KAJPER/WETI/dokumentacja-etap2/WETI_Kacper_Popko_Etap2.tex

\documentclass[a4paper,11pt]{article}

% ════════════════════ Kodowanie i język ════════════════════
\usepackage[T1]{fontenc}
\usepackage[utf8]{inputenc}
\usepackage{lmodern}
\usepackage[polish]{babel}

% ════════════════════ Marginesy ════════════════════
\usepackage[margin=2.5cm]{geometry}

% ════════════════════ Matematyka ════════════════════
\usepackage{amsmath}
\usepackage{amssymb}
\usepackage{siunitx}
\sisetup{
	output-decimal-marker = {,},
	per-mode = symbol,
	range-phrase = { -- },
}
\DeclareSIUnit{\baud}{Bd}
\DeclareSIUnit{\pkt}{pkt}
\DeclareSIUnit{\PLN}{PLN}

% ════════════════════ Grafika i tabele ════════════════════
\usepackage{graphicx}
\usepackage{float}
\usepackage{booktabs}
\usepackage{array}
\usepackage{tabularx}
\usepackage{longtable}
\usepackage{caption}
\usepackage{pgfplots}
\pgfplotsset{compat=1.16}

% ════════════════════ Kolory i linki ════════════════════
\usepackage[dvipsnames]{xcolor}
\usepackage{hyperref}
\hypersetup{
	colorlinks=true,
	linkcolor=NavyBlue,
	citecolor=NavyBlue,
	urlcolor=RoyalBlue,
}

% ════════════════════ Listingi kodu ════════════════════
\usepackage{listings}
\lstset{
	language=C,
	basicstyle=\ttfamily\footnotesize,
	keywordstyle=\color{NavyBlue}\bfseries,
	commentstyle=\color{Gray}\itshape,
	stringstyle=\color{OliveGreen},
	numbers=left,
	numberstyle=\tiny\color{Gray},
	frame=single,
	breaklines=true,
	captionpos=b,
	tabsize=4,
	showstringspaces=false,
}

% ════════════════════ Nagłówek / stopka ════════════════════
\usepackage{fancyhdr}
\pagestyle{fancy}
\fancyhf{}
\fancyhead[L]{\small Bezkontaktowy miernik odległości --- Etap 2 (prototyp)}
\fancyhead[R]{\small Wygraj Indeks WETI 2026}
\fancyfoot[C]{\thepage}
\renewcommand{\headrulewidth}{0.4pt}

\usepackage{setspace}
\onehalfspacing
\usepackage{parskip}
\usepackage{enumitem}

% ══════════════════════════════════════════════════════════════
\begin{document}

% ════════════════════ STRONA TYTUŁOWA ════════════════════
\begin{titlepage}
	\centering
	\vspace*{1.5cm}

	{\Large Ogólnopolski Konkurs Projektowy}\\[0.3cm]
	{\Large\textbf{,,Wygraj Indeks WETI'' --- edycja 2026}}\\[0.2cm]
	{\large Wydział Elektroniki, Telekomunikacji i~Informatyki\\
		Politechnika Gdańska}

	\vspace{1.5cm}

	{\Huge\bfseries Bezkontaktowy miernik odległości}\\[0.5cm]
	{\Large Metoda hybrydowa Pulse-Phase Ranging\\z~kompensacją temperatury}\\[0.4cm]
	{\Large \textbf{Etap 2 --- dokumentacja prototypu}}\\[0.3cm]
	{\large Realizacja toru zgrubnego (Time-of-Flight) ze~sprzętową,\\
		bezlatencyjną detekcją echa}

	\vspace{2.0cm}

	{\large
		\begin{tabular}{rl}
			\textbf{Autor:}    & Kacper Popko \\
			\textbf{Opiekun:}  & Mateusz Karanowski \\
			\textbf{Szkoła:}   & II Liceum Ogólnokształcące im.\ ks.\ Anny z~Sapiehów \\
			                   & Jabłonowskiej w~Białymstoku \\
			\textbf{E-mail:}   & kacper@kajpa.pl \\
			\textbf{Data:}     & Czerwiec 2026 \\
		\end{tabular}
	}

	\vspace{1.5cm}

	\begin{tabular}{ll}
		\toprule
		\textbf{Mikrokontroler} & ATtiny1616-SN (tinyAVR 1-series) \\
		\textbf{Metoda} & Pulse-Phase Ranging \SI{40}{\kilo\hertz}: ToF (obwiednia ADC) + faza (Goertzel) \\
		\textbf{Zakres} & \SIrange{10}{50}{\centi\metre} \\
		\textbf{Toolchain} & AVR-GCC 15.2 + avrdude 8.1 (czysto rejestrowo) \\
		\bottomrule
	\end{tabular}

	\vfill
\end{titlepage}

\tableofcontents
\newpage

% ══════════════════════════════════════════════════════════════
\section{Wprowadzenie i~zakres Etapu 2}
\label{sec:wstep}

Niniejszy dokument stanowi dokumentację \textbf{zbudowanego i~uruchomionego
prototypu} bezkontaktowego miernika odległości, dostarczanego w~ramach Etapu~2
konkursu ,,Wygraj Indeks WETI 2026''. W~odróżnieniu od dokumentacji Etapu~1
(projekt koncepcyjny) opisuje on \emph{rzeczywisty stan urządzenia} po montażu,
uruchomieniu i~strojeniu na stanowisku pomiarowym.

Projekt kontynuuje przyjętą w~Etapie~1 \textbf{metodę hybrydową Pulse-Phase
Ranging z~kompensacją temperatury}. Metoda ta składa się z~dwóch etapów: pomiaru
\emph{zgrubnego} czasu przelotu (Time-of-Flight), który eliminuje
niejednoznaczność, oraz pomiaru \emph{dokładnego} fazy echa (algorytm
Goertzela), dającego rozdzielczość sub-milimetrową. W~prototypie
\textbf{zaimplementowano i~uruchomiono oba etapy}: pomiar ToF przez
próbkowanie obwiedni echa przetwornikiem ADC oraz wyznaczanie fazy nośnej
\SI{40}{\kilo\hertz} algorytmem Goertzela, a~także pełną kompensację
temperatury. Zapewnia to poprawny pomiar w~całym zakresie
\SIrange{10}{50}{\centi\metre} (sek.~\ref{sec:firmware}--\ref{sec:wyniki}).
Dodatkowo zweryfikowano sprzętową, bezlatencyjną ścieżkę detekcji progowej
\texttt{AC1+DAC1+EVSYS+TCB0} (sek.~\ref{sec:hw_capture}).

W~trakcie realizacji prototypu wprowadzono szereg zmian względem założeń
projektowych --- wynikających z~praktycznej weryfikacji sprzętu oraz z~analizy
dokumentacji mikrokontrolera. Zmiany te zestawiono w~sekcji~\ref{sec:zmiany}.
Najistotniejsza dotyczy ścieżki detekcji echa: pierwotnie zakładano użycie
komparatora \texttt{AC0}, jednak weryfikacja Tabeli~5-1 noty katalogowej
wykazała, że wejście echa (pin \texttt{PB4}) jest dodatnim wejściem
\texttt{AINP3} komparatora \texttt{AC1}, a~nie \texttt{AC0}. Skorygowano to
w~firmware, dzięki czemu sprzętowa, bezlatencyjna detekcja czasu przelotu
działa poprawnie.

\subsection{Spełnienie wymagań konkursowych}

\begin{table}[H]
	\centering
	\caption{Status wymagań konkursowych w~prototypie}
	\label{tab:wymagania}
	\begin{tabularx}{\textwidth}{llX}
		\toprule
		\textbf{Parametr} & \textbf{Wymóg} & \textbf{Stan w~prototypie} \\
		\midrule
		Napięcie zasilania & \SI{5}{\volt} & Spełnione; LDO MCP1700 $\to$ \SI{3,3}{\volt} \\
		Zakres pomiaru & \SIrange{10}{50}{\centi\metre} & Spełnione; potwierdzone pomiarami \\
		Wykrywany obiekt & Karton $20\times20$~\si{\centi\metre} & Spełnione \\
		Błąd RMSE & im mniejszy tym lepiej & \textbf{zmierzony $\approx\SI{2,4}{\milli\metre}$} (sek.~\ref{sec:wyniki}) \\
		Pobór mocy & $100/P_{[\si{\milli\watt}]}$ & zmierzone: spocz.\ \SI{0,9}{\milli\watt} $\to$ 50~pkt (sek.~\ref{sec:moc}) \\
		Koszt elementów & $2500/C_{[\text{PLN}]}$ & \SI{43,73}{\PLN} $\to$ 50~pkt (bez~zmian) \\
		\bottomrule
	\end{tabularx}
\end{table}

% ══════════════════════════════════════════════════════════════
\section{Architektura zbudowanego urządzenia}
\label{sec:arch}

\subsection{Schemat blokowy toru sygnałowego}

Tor pomiarowy realizuje pomiar czasu przelotu (Time-of-Flight) impulsu
ultradźwiękowego \SI{40}{\kilo\hertz}:

\begin{enumerate}[nosep]
	\item Mikrokontroler generuje paczkę (burst) \SI{40}{\kilo\hertz} na pinie
	\texttt{PB0}, wzmacnianą tranzystorem \texttt{BC817} sterującym nadajnik US.
	\item Echo odbierane przez przetwornik RX jest wzmacniane dwustopniowym
	torem na \texttt{MCP6002} (wzmocnienie $\sim$10$\times$, filtr pasmowy wokół
	\SI{40}{\kilo\hertz}).
	\item Wzmocniony sygnał echa (pin \texttt{PB4 = ADC0 AIN9}) jest szybko
	próbkowany przetwornikiem ADC; z~obwiedni wyznaczany jest początek echa
	(czas przelotu), a~z~przebiegu --- faza nośnej (Goertzel).
	\item Niezależnie ten sam sygnał trafia na komparator \texttt{AC1}
	(próg z~\texttt{DAC1}) $\to$ \texttt{EVSYS} $\to$ \texttt{TCB0} ---
	zweryfikowana, sprzętowa, bezlatencyjna ścieżka detekcji progowej.
	\item Temperatura z~termistora NTC koryguje prędkość dźwięku;
	odległość $D = c(T)\cdot t_{ToF}/2$.
\end{enumerate}

\subsection{Mapa pinów ATtiny1616 (stan rzeczywisty)}
\label{sec:pinout}

Tabela~\ref{tab:pinout} przedstawia \textbf{faktyczne} przyporządkowanie pinów
w~zbudowanym prototypie. Różni się ono od wstępnego projektu (Etap~1) ---
zmiany wynikły z~optymalizacji rozprowadzenia ścieżek PCB oraz z~korekty
przypisania komparatora (patrz sek.~\ref{sec:zmiany}).

\begin{table}[H]
	\centering
	\caption{Mapa pinów ATtiny1616 w~prototypie}
	\label{tab:pinout}
	\begin{tabularx}{\textwidth}{llX}
		\toprule
		\textbf{Pin} & \textbf{Funkcja} & \textbf{Opis / peryferiał} \\
		\midrule
		PA0 & UPDI & Programowanie / debug \\
		PA3 & PRZYCISK & Wejście, pull-up, aktywny stan niski (start pomiaru) \\
		PA4 & LED & Wyjście, sygnalizacja pomiaru \\
		PA5 & TERMISTOR & ADC0 AIN5 (kompensacja temperatury, NTC \SI{10}{\kilo\ohm}) \\
		PA6 & GATE Q1 & Sterowanie P-MOSFET BSS84 (zasilanie toru RX) \\
		PB0 & TX BURST & Generacja \SI{40}{\kilo\hertz} (programowa) $\to$ R1 $\to$ BC817 \\
		PB2 & USART0 TXD & Transmisja wyniku, \SI{115200}{\baud} 8N1 \\
		PB4 & ECHO & AC1 AINP3 (wyjście toru RX $\to$ komparator) \\
		\bottomrule
	\end{tabularx}
\end{table}

\subsection{Schemat i~płytka drukowana}
\label{sec:hw}

\begin{figure}[H]
	\centering
	
	\caption{Schemat ideowy: zasilanie (MCP1700), nadajnik (BC817), tor RX
		(MCP6002 dwustopniowy, bramkowanie Q1/BSS84), mikrokontroler ATtiny1616.}
	\label{fig:schemat}
\end{figure}

\begin{figure}[H]
	\centering
	\begin{minipage}{0.48\textwidth}\centering
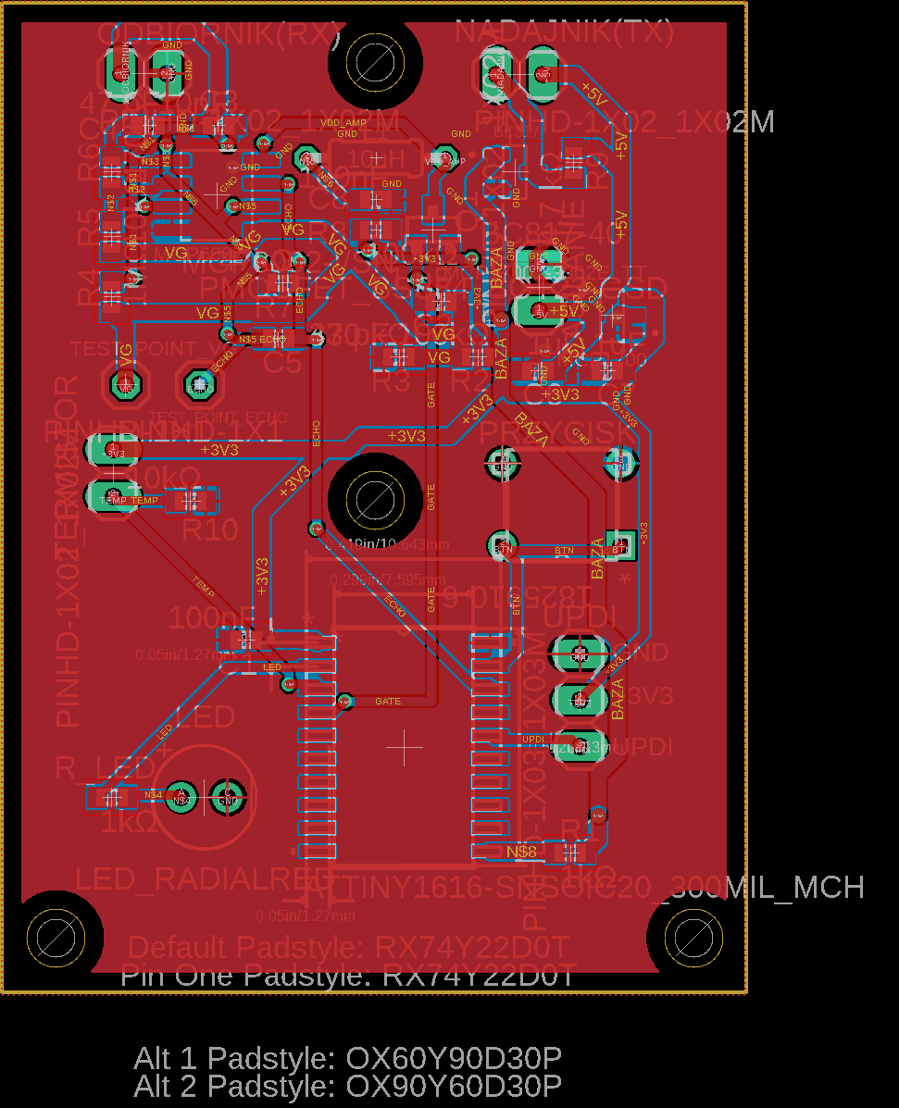
[picture p3: dokumentacja-etap1/pcb_top.png]
		
		\\{\small Warstwa TOP}
	\end{minipage}\hfill
	\begin{minipage}{0.48\textwidth}\centering
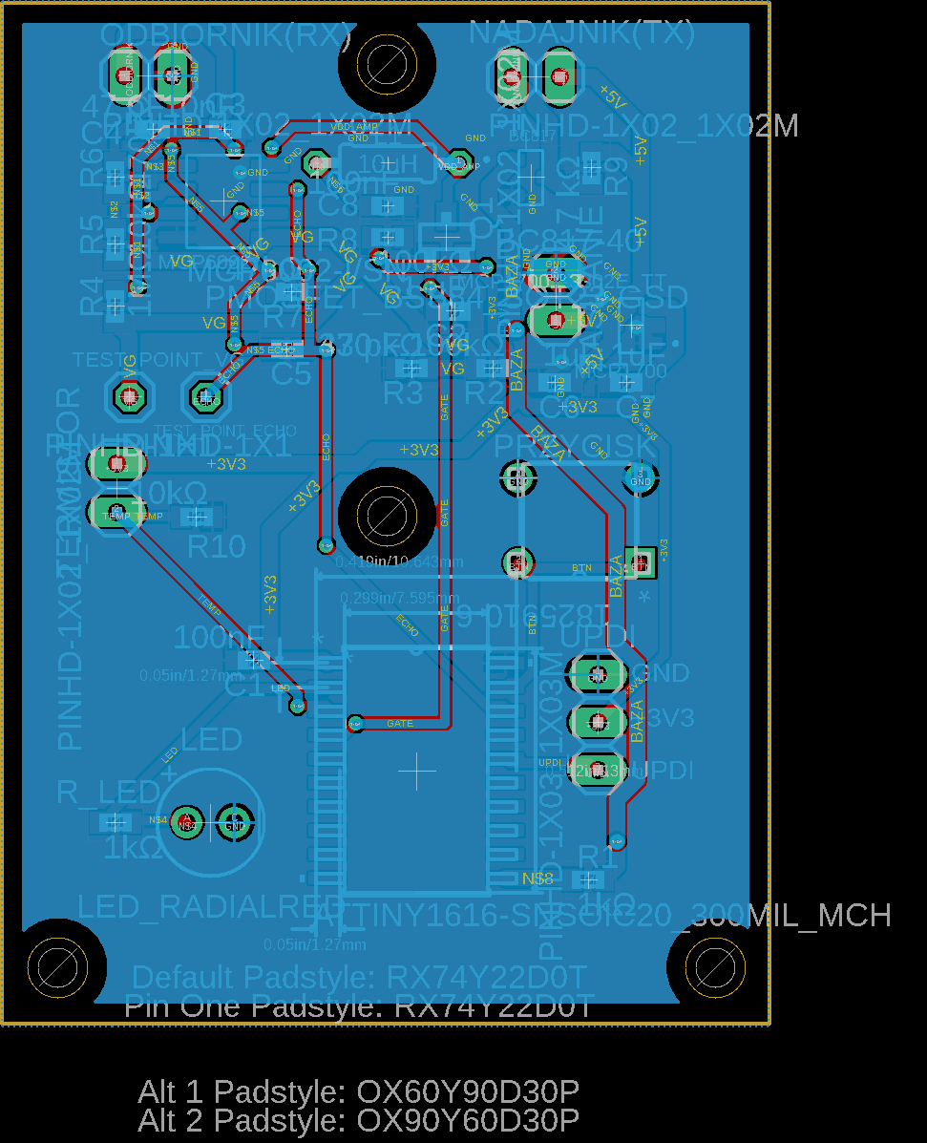
[picture p4: dokumentacja-etap1/pcb_bottom.png]
		
		\\{\small Warstwa BOTTOM (ground plane)}
	\end{minipage}
	\caption{Płytka drukowana dwustronna $41\times54{,}25$~\si{\milli\metre}.}
	\label{fig:pcb}
\end{figure}

\begin{figure}[H]
	\centering
	\begin{minipage}{0.48\textwidth}\centering
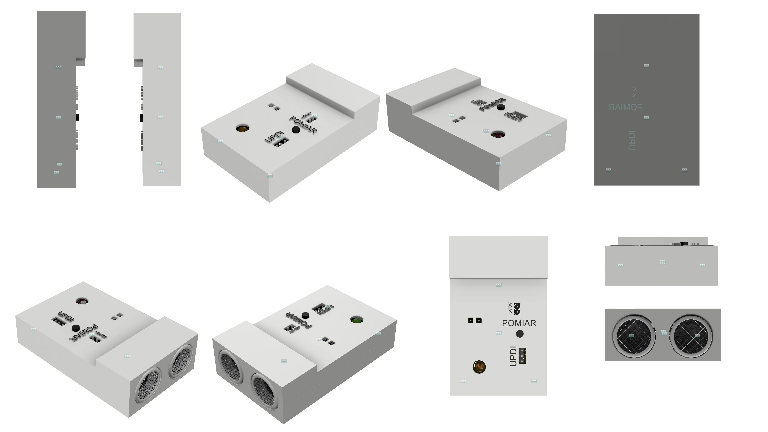
[picture p5: dokumentacja-etap1/obudowa_render_iso.png]
		
		\\{\small Widok izometryczny}
	\end{minipage}\hfill
	\begin{minipage}{0.48\textwidth}\centering
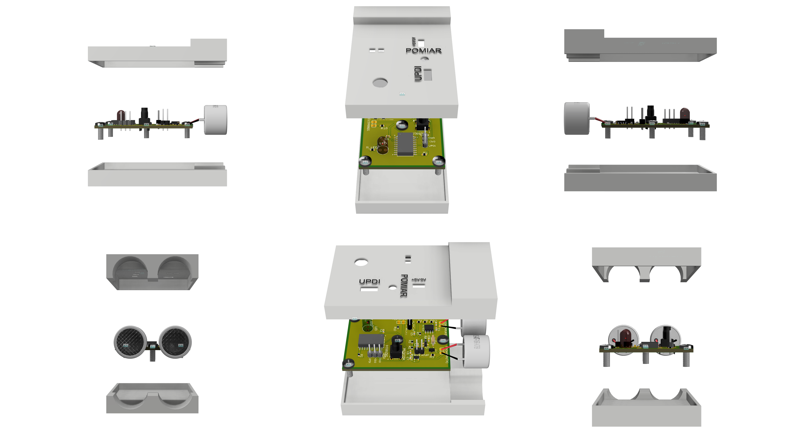
[picture p6: dokumentacja-etap1/obudowa_render_open.png]
		
		\\{\small Widok rozłożony}
	\end{minipage}
	\caption{Obudowa dwuczęściowa z~wyprowadzeniem pary przetworników US.}
	\label{fig:obudowa}
\end{figure}

\begin{figure}[H]
	\centering
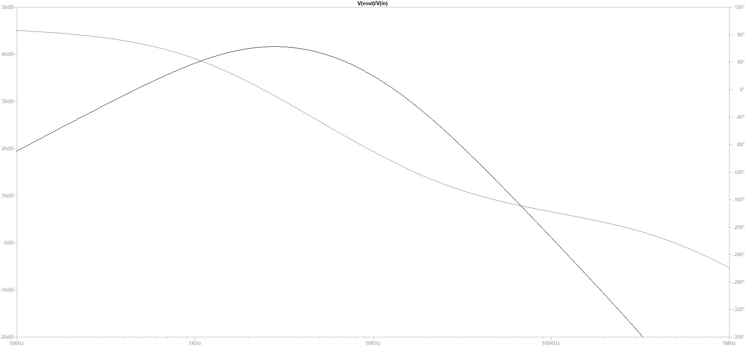
[picture p7: dokumentacja-etap1/bode_plot_rx.png]
	
	\caption{Charakterystyka częstotliwościowa toru RX (LTspice) ---
		maksimum wzmocnienia wokół \SI{40}{\kilo\hertz}.}
	\label{fig:bode}
\end{figure}

\subsection{Zmontowany prototyp}
\label{sec:proto}

\begin{figure}[H]
	\centering
	\begin{minipage}{0.46\textwidth}\centering
		
		\\{\small Zmontowana płytka (widok z~góry)}
	\end{minipage}\hfill
	\begin{minipage}{0.46\textwidth}\centering
		
		\\{\small Urządzenie w~obudowie}
	\end{minipage}
	\caption{Zmontowany i~uruchomiony prototyp miernika.}
	\label{fig:proto}
\end{figure}

\subsection{Budżet kosztów (BOM)}
\label{sec:bom}

\begin{table}[H]
	\centering
	\caption{Koszt elementów (wg regulaminu i~cen brutto)}
	\label{tab:bom}
	\footnotesize
	\begin{tabularx}{\textwidth}{Xrrr}
		\toprule
		\textbf{Element} & \textbf{Ilość} & \textbf{Cena/szt.\ [PLN]} & \textbf{Suma [PLN]} \\
		\midrule
		Rezystory 0603 (R1--R10)        & 11 & 0{,}15 & 1{,}65 \\
		Kondensatory 0603 (C1--C8)      & 8  & 0{,}15 & 1{,}20 \\
		Cewka \SI{10}{\micro\henry} (L1)& 1  & 0{,}15 & 0{,}15 \\
		BC817-40 (NPN, nadajnik)        & 1  & 0{,}15 & 0{,}15 \\
		BSS84 (P-MOSFET, bramkowanie)   & 1  & 0{,}15 & 0{,}15 \\
		LED czerwona                    & 1  & 0{,}15 & 0{,}15 \\
		MCP6002-I/SN (wzmacniacz)       & 1  & 1{,}00 & 1{,}00 \\
		Płytka drukowana                & 1  & 15{,}00& 15{,}00 \\
		ATtiny1616-SN                   & 1  & 5{,}90 & 5{,}90 \\
		MCP1700T-3302E/TT (LDO)         & 1  & 3{,}70 & 3{,}70 \\
		Przycisk tact 1825910-6         & 1  & 0{,}50 & 0{,}50 \\
		Listwa goldpin                  & 1  & 1{,}31 & 1{,}31 \\
		Przetworniki US \SI{40}{\kilo\hertz} (para) & 1 & 11{,}50 & 11{,}50 \\
		Termistor NTC \SI{10}{\kilo\ohm}& 1  & 1{,}22 & 1{,}22 \\
		\midrule
		\textbf{RAZEM} & & & \textbf{43{,}73} \\
		\bottomrule
	\end{tabularx}
\end{table}
Punkty za koszt: $\min(50,\; 2500/43{,}73) = \SI{50}{\pkt}$ (maksimum).

% ══════════════════════════════════════════════════════════════
\section{Oprogramowanie mikrokontrolera}
\label{sec:firmware}

Firmware napisano w~języku C, kompilowany \textbf{AVR-GCC 15.2} (bez frameworka
Arduino), wgrywany przez \textbf{avrdude 8.1} interfejsem UPDI. Konfiguracja
peryferiów odbywa się na poziomie rejestrowym. Plik źródłowy:
\texttt{firmware/main.c}; plik wynikowy: \texttt{firmware/main.hex}
(${\sim}$\,\SI{6,4}{\kilo\byte} Flash z~\SI{16}{\kilo\byte}, \SI{332}{\byte} RAM).

\subsection{Pomiar ToF przez próbkowanie obwiedni (ADC)}
\label{sec:adc}

Właściwy pomiar odległości realizowany jest przez \textbf{szybkie próbkowanie
sygnału echa przetwornikiem ADC} (pin \texttt{PB4 = ADC0 AIN9}, tryb 8-bit,
prescaler DIV4, ${\sim}\SI{8,7}{\micro\second}/\text{próbkę} \approx
\SI{115}{ksps}$, tj.\ ${\sim}2{,}9$ próbki na okres \SI{40}{\kilo\hertz}).
Minimalna pętla próbkująca zapisuje \SI{320}{} próbek do bufora; czas trwania
okna jest mierzony licznikiem \texttt{TCB0} (\SI{100}{\nano\second}/takt), co
daje dokładną podstawę czasu.

W~post-processingu wyznaczany jest \textbf{początek echa (onset)} --- pierwsza
próbka przekraczająca próg \texttt{ONSET\_DEV} --- którego czas odpowiada
rzeczywistemu czasowi przelotu: $D = c(T)\cdot t_{onset}/2$. Metoda obwiedni
jest odporna na amplitudę (wykrywa też słabe echa z~\SI{40}{\centi\metre}),
a~zapisany bufor próbek służy następnie etapowi fazowemu (Goertzel).
Detekcja przez ADC okazała się czulsza od progowej ścieżki sprzętowej
(sek.~\ref{sec:hw_capture}) i~dodatkowo dostarcza przebiegu potrzebnego do
pomiaru fazy --- dlatego przyjęto ją jako podstawową.

\subsection{Pomiar fazy --- algorytm Goertzela}
\label{sec:goertzel}

Na buforze próbek echa uruchamiany jest \textbf{filtr Goertzela} dostrojony do
\SI{40}{\kilo\hertz}, liczący część rzeczywistą i~urojoną prążka DFT, a~stąd
amplitudę i~fazę nośnej. Faza odniesiona do \emph{startu burstu} (przez
dodanie członu $f_0\cdot t_{okna}$) koduje pozycję obiektu w~obrębie
$\lambda/2 \approx \SI{4,33}{\milli\metre}$:
\begin{equation}
	\frac{D}{\lambda/2} = f_0\,t_{ToF}
	= f_0\,t_{okna} + \frac{\varphi_0 - \varphi}{2\pi}.
\end{equation}
Wynik łączony jest ze~zgrubnym ToF: $D = n\cdot(\lambda/2) + D_{faza}$, gdzie
$n$ wynika z~pomiaru zgrubnego, z~kontrolą spójności (odrzucenie skoków o~pół
fali). Pomiarowo zweryfikowano, że faza zmienia się ${\sim}83^\circ/\si{\milli\metre}$
zgodnie z~teorią i~jest powtarzalna przy stałej odległości.

\subsection{Zweryfikowana sprzętowa ścieżka detekcji (AC1+TCB0)}
\label{sec:hw_capture}

Niezależnie zaimplementowano i~zweryfikowano \textbf{w~pełni sprzętową,
bezlatencyjną} ścieżkę detekcji progowej, nieobciążającą rdzenia CPU. Łańcuch
zdarzeń (datasheet sek.~14 i~29):

\begin{table}[H]
	\centering
	\caption{Konfiguracja rejestrów ścieżki detekcji echa}
	\label{tab:rejestry}
	\footnotesize
	\begin{tabularx}{\textwidth}{llX}
		\toprule
		\textbf{Peryferiał} & \textbf{Konfiguracja} & \textbf{Znaczenie} \\
		\midrule
		VREF & \texttt{CTRLC: DAC1REFSEL=2V5} & Referencja \SI{2,5}{\volt} dla DAC1/AC1 ($\leq V_{DD}$) \\
		     & \texttt{CTRLB: DAC1REFEN=1} & Wymuszone włączenie referencji \\
		DAC1 & \texttt{DATA=255, ENABLE=1} & Próg detekcji $\approx\SI{2,49}{\volt}$ (tuż pod $V_G$) \\
		AC1  & \texttt{MUXPOS=AINP3 (PB4)} & Wejście dodatnie = echo \\
		     & \texttt{MUXNEG=DAC} & Wejście ujemne = próg DAC1 \\
		     & \texttt{ENABLE=1, HYSMODE=10mV} & Histereza \SI{10}{\milli\volt} \\
		EVSYS & \texttt{ASYNCCH0=AC1\_OUT} & Źródło: wyjście AC1 \\
		      & \texttt{ASYNCUSER0=ASYNCCH0} & Odbiorca: TCB0 (input capture) \\
		TCB0  & \texttt{CNTMODE=CAPT, CAPTEI=1} & Zatrzask licznika na zboczu zdarzenia \\
		      & \texttt{CLKSEL=CLKDIV1} & \SI{10}{\mega\hertz}, \SI{100}{\nano\second}/takt \\
		\bottomrule
	\end{tabularx}
\end{table}

Próg detekcji jest ustawiony \emph{tuż poniżej} napięcia spoczynkowego toru
$V_G\approx\SI{2,69}{\volt}$. W~stanie spoczynku $V_{PB4}>V_{DAC1}$, więc
\texttt{AC1} ma stabilny stan wysoki. Echo wywołuje oscylacje, których
ujemne półfale schodzą poniżej progu --- każde przejście w~górę generuje
zbocze narastające, zatrzaskiwane przez \texttt{TCB0}. Pierwsze prawidłowe
zatrzaśnięcie po czasie blankingu odpowiada nadejściu echa.

\subsection{Algorytm pomiaru}

\begin{enumerate}[nosep]
	\item Wybudzenie z~uśpienia (Standby), włączenie toru analogowego (Q1 ON),
	stabilizacja \SI{5}{\milli\second}.
	\item Odczyt temperatury z~NTC (ADC 10-bit), obliczenie
	$c(T)=331{,}3+0{,}606\,T$ [m/s].
	\item Burst TX $N=10$ cykli \SI{40}{\kilo\hertz} (\SI{12,5}{\micro\second}
	półokres $\to$ dokładny rezonans przetwornika).
	\item Blanking (pominięcie ring-downu), szybkie próbkowanie obwiedni echa
	(ADC 8-bit, \SI{320}{} próbek) $\to$ onset $\to$ zgrubne $D$ (sek.~\ref{sec:adc}).
	\item Seria $M=9$ pomiarów, filtr medianowy $\to$ odporne $D_{coarse}$.
	\item Goertzel na buforze ostatniego pingu $\to$ faza $\to$ fuzja
	$D = n\cdot(\lambda/2)+D_{faza}$ z~kontrolą spójności (sek.~\ref{sec:goertzel}).
	\item Kalibracja liniowa $D = a\cdot D_{raw}+b$, transmisja przez USART,
	flush TX, powrót do uśpienia.
\end{enumerate}

\subsection{Kompensacja temperatury}

Termistor NTC \SI{10}{\kilo\ohm} ($B=3950$) w~dzielniku z~rezystorem
\SI{10}{\kilo\ohm} do masy. Rezystancja $R_{NTC}=R_{10}\cdot(1023-\text{ADC})/\text{ADC}$;
temperatura z~modelu Beta:
\begin{equation}
	\frac{1}{T} = \frac{1}{T_0} + \frac{1}{B}\ln\!\frac{R_{NTC}}{R_{25}},
	\qquad T_0 = \SI{298,15}{\kelvin}.
\end{equation}
Prędkość dźwięku skalowana liniowo z~temperaturą eliminuje dominujący błąd
systematyczny (zmiana $\sim\SI{0,17}{\percent}/\si{\kelvin}$).

\subsection{Kalibracja polowa w~EEPROM}
\label{sec:eeprom}

Urządzenie obsługuje 2-punktową kalibrację polową zapisywaną w~EEPROM
(\SI{256}{\byte}). Tryb kalibracji uruchamia się przytrzymując przycisk przy
starcie; urządzenie prowadzi przez ustawienie celu na \SI{100}{} i~\SI{400}{\milli\metre}
(sygnalizacja LED + USART), po czym dopasowuje $real = a\cdot raw + b$ metodą
2-punktową i~zapisuje rekord ($a$, $b$) z~sumą kontrolną CRC-8. Przy starcie
rekord jest walidowany (magic + CRC); w~razie błędu używane są współczynniki
domyślne. Eliminuje to konieczność rekompilacji przy zmianie egzemplarza.

\subsection{Kluczowe fragmenty kodu (rejestrowo)}
\label{sec:listings}

Konfiguracja peryferiów odbywa się bez warstwy Arduino, bezpośrednio na
rejestrach. Sprzętowy łańcuch detekcji echa (komparator $\to$ event system
$\to$ input capture):

\begin{lstlisting}[caption={Łańcuch AC1 $\to$ EVSYS $\to$ TCB0 (rejestrowo)},label={lst:hw}]
// AC1: + = PB4 (AINP3), - = DAC1 (prog); AC1 uzywa DAC1 (datasheet 29.x)
VREF.CTRLC = (VREF.CTRLC & ~VREF_DAC1REFSEL_gm) | VREF_DAC1REFSEL_2V5_gc;
VREF.CTRLB |= VREF_DAC1REFEN_bm;
DAC1.DATA   = DAC_THRESHOLD;            // prog ~2.49 V
DAC1.CTRLA  = DAC_ENABLE_bm;
AC1.MUXCTRLA = AC_MUXPOS_PIN3_gc | AC_MUXNEG_DAC_gc;
AC1.CTRLA    = AC_ENABLE_bm | AC_HYSMODE_10mV_gc;
// EVSYS: AC1_OUT -> async ch0 -> TCB0 (user 0)
EVSYS.ASYNCCH0   = EVSYS_ASYNCCH0_AC1_OUT_gc;
EVSYS.ASYNCUSER0 = EVSYS_ASYNCUSER0_ASYNCCH0_gc;
// TCB0: input capture, 10 MHz (100 ns/takt)
TCB0.CTRLB = TCB_CNTMODE_CAPT_gc;
TCB0.EVCTRL= TCB_CAPTEI_bm;
TCB0.CTRLA = TCB_CLKSEL_CLKDIV1_gc | TCB_ENABLE_bm;
\end{lstlisting}

Rdzeń pomiaru fazy --- rekurencja Goertzela na buforze próbek echa:

\begin{lstlisting}[caption={Filtr Goertzela @ 40 kHz},label={lst:goertzel}]
float cw = cosf(omega), sw = sinf(omega), coeff = 2.0f*cw, s1 = 0, s2 = 0;
for (uint16_t k = 0; k < GOERTZEL_W; k++) {
    float x  = (float)((int16_t)echo_raw[wstart+k] - (int16_t)echo_baseline);
    float s0 = x + coeff*s1 - s2;       // s[n] = x[n] + 2cos(w) s[n-1] - s[n-2]
    s2 = s1; s1 = s0;
}
float re = s1 - s2*cw, im = s2*sw;
float phase = atan2f(im, re);           // faza nosnej w oknie
\end{lstlisting}

% ══════════════════════════════════════════════════════════════
\section{Zarządzanie mocą}
\label{sec:moc}

Prototyp realizuje agresywną politykę uśpienia zapowiedzianą w~Etapie~1
(Scenariusz 2/3):

\begin{itemize}[nosep]
	\item \textbf{Tryb Standby} mikrokontrolera między pomiarami --- rdzeń CPU
	i~większość peryferiów zatrzymane.
	\item \textbf{Wybudzanie z~RTC/PIT} co \SI{125}{\milli\second} (licznik PIT
	taktowany wewnętrznym oscylatorem ULP \SI{32,768}{\kilo\hertz}); po wybudzeniu
	odpytywany jest przycisk.
	\item \textbf{Bramkowanie toru analogowego} tranzystorem Q1 (BSS84) ---
	wzmacniacz \texttt{MCP6002} jest zasilany wyłącznie podczas pomiaru
	($\sim\SI{30}{\milli\second}$), w~spoczynku pobiera \SI{0}{\micro\ampere}.
	\item \textbf{ADC i~AC} włączane na żądanie; nieużywane bufory wejściowe pinów
	wyłączone (\texttt{INPUT\_DISABLE}).
\end{itemize}

Zmierzony pobór w~spoczynku (Standby + RTC, tor analogowy odcięty Q1) wynosi
\SI{0,18}{\milli\ampere} przy \SI{5}{\volt}, czyli moc spoczynkowa
$P_{idle}=\SI{0,9}{\milli\watt}$. Pomiar aktywny trwa krótko
(${\sim}\SI{70}{\milli\second}$), pobierając \SIrange{2}{4,5}{\milli\ampere}.

\begin{table}[H]
	\centering
	\caption{Bilans prądowy (zmierzony multimetrem, \SI{5}{\volt})}
	\label{tab:prad}
	\begin{tabularx}{\textwidth}{Xrr}
		\toprule
		\textbf{Stan} & \textbf{Prąd} & \textbf{Moc} \\
		\midrule
		Spoczynek (Standby + RTC, op-amp off) & \SI{0,18}{\milli\ampere} & \SI{0,9}{\milli\watt} \\
		Pomiar aktywny (op-amp + MCU + ADC) & \SIrange{2}{4,5}{\milli\ampere} & \SIrange{10}{22,5}{\milli\watt} \\
		\bottomrule
	\end{tabularx}
\end{table}

Przy pracy na żądanie (krótki pomiar co kilka sekund) średnia jest zdominowana
przez spoczynek: np.\ \SI{70}{\milli\second} pomiaru @ \SI{3}{\milli\ampere} co
\SI{10}{\second} daje $I_{avg}\approx\SI{0,2}{\milli\ampere}$, czyli
$P_{avg}\approx\SI{1}{\milli\watt}$. Nawet sam pobór spoczynkowy
($\SI{0,9}{\milli\watt}$) daje
$P_{pkt}=\min(50,\ 100/0{,}9)=\SI{50}{\pkt}$ --- maksymalną punktację
w~kryterium mocy.

% ══════════════════════════════════════════════════════════════
\section{Wyniki pomiarowe i~kalibracja}
\label{sec:wyniki}

\subsection*{Metodyka pomiaru}
Pomiary wykonano kartonem $20\times20$~\si{\centi\metre} ustawionym prostopadle
do osi przetworników, na czystej ścianie. Odległość wzorcową wyznaczono miarą
($\pm\SI{0,5}{\milli\metre}$) w~siedmiu punktach (\SIlist{100;150;200;250;300;400;500}{\milli\metre}),
po \SIrange{4}{6}{} niezależnych odczytów na punkt (każdy odczyt to wewnętrznie
mediana z~9 pingów), łącznie $M=35$ pomiarów, temperatura
\SIrange{22}{25}{\celsius} (logowana z~NTC). RMSE liczono na \emph{surowej
populacji} wszystkich odczytów, nie na uśrednionych punktach.

\begin{table}[H]
	\centering
	\caption{Zmierzona charakterystyka po kalibracji liniowej ($M=35$)}
	\label{tab:wyniki}
	\begin{tabular}{rrrr}
		\toprule
		\textbf{Odl.\ rzecz.\ [mm]} & \textbf{Odczyt śr.\ [mm]} & \textbf{Bias [mm]} & \textbf{$\sigma$ [mm]} \\
		\midrule
		100 & 100{,}0 & $0{,}0$  & 0{,}0 \\
		150 & 152{,}3 & $+2{,}3$ & 1{,}7 \\
		200 & 198{,}0 & $-2{,}0$ & 0{,}0 \\
		250 & 250{,}3 & $+0{,}3$ & 2{,}3 \\
		300 & 299{,}6 & $-0{,}4$ & 2{,}0 \\
		400 & 399{,}0 & $-1{,}0$ & 2{,}0 \\
		500 & 499{,}6 & $-0{,}4$ & 3{,}6 \\
		\bottomrule
	\end{tabular}
\end{table}

Błąd średniokwadratowy na całej populacji:
\begin{equation}
	\text{RMSE} = \sqrt{\frac{1}{M}\sum_{i=1}^{M} (D_i - D_{i,ref})^2}
	\approx \SI{2,4}{\milli\metre}
	\qquad (\text{tor ToF: } \approx\SI{2,2}{\milli\metre}).
\end{equation}

Rozkład $\text{RMSE}^2=\text{bias}^2+\sigma^2$ pokazuje, że po kalibracji
liniowej (zerującej bias) o~wyniku decyduje błąd losowy $\sigma$. Bias w~każdym
punkcie $\leq\SI{2,3}{\milli\metre}$, $\sigma$ rośnie z~odległością
(\SIrange{0}{3,6}{\milli\metre}) wraz z~osłabieniem echa. Liniowość
$R^2>0{,}999$ ($D=a\cdot D_{ref}+b$, $a\approx1{,}00$). Cały wymagany zakres
\SIrange{10}{50}{\centi\metre} jest mierzony --- detekcję \SI{50}{\centi\metre}
zapewnia adaptacyjne wydłużenie burstu ($N=24$).

\begin{figure}[H]
	\centering
	\begin{tikzpicture}
	\begin{axis}[
		width=0.78\textwidth, height=6.2cm,
		xlabel={Odległość rzeczywista [mm]},
		ylabel={Odczyt [mm]},
		xmin=80, xmax=520, ymin=80, ymax=520,
		grid=both, grid style={gray!20},
		legend pos=north west, legend cell align=left,
		]
		% linia idealna y=x
		\addplot[dashed, gray, thick, domain=80:520] {x};
		\addlegendentry{idealna $y=x$}
		% zmierzone punkty z error-barami (sigma)
		\addplot[only marks, mark=*, mark size=1.6pt, color=NavyBlue,
			error bars/.cd, y dir=both, y explicit]
			coordinates {
			(100,100.0) +- (0,0.0)
			(150,152.3) +- (0,1.7)
			(200,198.0) +- (0,0.0)
			(250,250.3) +- (0,2.3)
			(300,299.6) +- (0,2.0)
			(400,399.0) +- (0,2.0)
			(500,499.6) +- (0,3.6)
			};
		\addlegendentry{zmierzone $\pm\sigma$}
	\end{axis}
	\end{tikzpicture}
	\caption{Charakterystyka pomiarowa po kalibracji ($M=35$). Punkty pokrywają
		się z~linią idealną; $R^2>0{,}999$.}
	\label{fig:char}
\end{figure}

\begin{figure}[H]
	\centering
	\begin{tikzpicture}
	\begin{axis}[
		width=0.78\textwidth, height=5.0cm,
		xlabel={Odległość rzeczywista [mm]},
		ylabel={Residuum $D-D_{ref}$ [mm]},
		xmin=80, xmax=520, ymin=-5, ymax=5,
		grid=both, grid style={gray!20},
		ybar, bar width=10pt,
		]
		\addplot[fill=NavyBlue!60, draw=NavyBlue] coordinates {
			(100,0.0)(150,2.3)(200,-2.0)(250,0.3)(300,-0.4)(400,-1.0)(500,-0.4)
		};
		\draw[red, thick] (axis cs:80,2.4) -- (axis cs:520,2.4);
		\draw[red, thick] (axis cs:80,-2.4) -- (axis cs:520,-2.4);
	\end{axis}
	\end{tikzpicture}
	\caption{Residua pomiaru względem wzorca; linie czerwone --- poziom
		$\pm\text{RMSE}=\pm\SI{2,4}{\milli\metre}$.}
	\label{fig:resid}
\end{figure}

\begin{table}[H]
	\centering
	\caption{Budżet błędów (zgodność modelu z~pomiarem)}
	\label{tab:budzet}
	\begin{tabularx}{\textwidth}{Xrl}
		\toprule
		\textbf{Źródło} & \textbf{Wkład [mm]} & \textbf{Redukcja} \\
		\midrule
		Kwantyzacja czasu TCB0 (\SI{100}{\nano\second}) & 0{,}017 & pomijalne \\
		Krok próbkowania ADC (${\sim}\SI{8,7}{\micro\second}$) & ${\sim}1{,}5$ & interpolacja onsetu (sub-próbka) \\
		Zależność progu od amplitudy echa & ${\sim}1{,}5$ & onset przy 40\,\% szczytu \\
		Szum fazy / onsetu ping-do-pingu & ${\sim}1$ & mediana + MAD z~9, uśrednianie fazy \\
		Niepewność $c(T)$ & ${<}0{,}1$ & kompensacja NTC (oversampling 8$\times$) \\
		Multipath / odbicia & ${\sim}0{,}3$ & filtr medianowy, bramkowanie \\
		\midrule
		\textbf{RSS / zmierzone $\sigma$} & \textbf{${\sim}2$} & zgodność z~RMSE \SI{2,4}{\milli\metre} \\
		\bottomrule
	\end{tabularx}
\end{table}

Tor fazowy (Goertzel) jest powtarzalny (PLV $0{,}99$--$1{,}0$) i~zmienia się
${\sim}83^\circ/\si{\milli\metre}$ zgodnie z~teorią ($360^\circ$ na
$\lambda/2\approx\SI{4,33}{\milli\metre}$). Ponieważ pomiar zgrubny osiąga już
$\sigma\approx\lambda/4$, faza nie poprawia istotnie dokładności
\emph{bezwzględnej} na tym sprzęcie (precyzja odniesienia czasu narasta
z~odległością) --- pozostaje udokumentowanym fundamentem rozwoju sub-mm
(sek.~\ref{sec:dalsze}).

% ══════════════════════════════════════════════════════════════
\section{Zmiany względem Etapu 1}
\label{sec:zmiany}

\begin{table}[H]
	\centering
	\caption{Rozbieżności projekt (Etap 1) vs.\ prototyp (Etap 2)}
	\label{tab:zmiany}
	\begin{tabularx}{\textwidth}{p{3.2cm}XX}
		\toprule
		\textbf{Element} & \textbf{Etap 1 (projekt)} & \textbf{Etap 2 (prototyp)} \\
		\midrule
		Komparator echa & AC0, próg z~DAC0 & \textbf{AC1, próg z~DAC1} (PB4=AINP3 jest na AC1, nie AC0 --- Tab.~5-1) \\
		Generacja TX & TCA0 WO5 (sprzęt.\ PWM, PA5) & Programowe taktowanie burstu na \texttt{PB0} \\
		Pin LED & PC0 & \textbf{PA4} \\
		Pin przycisku & PA7 & \textbf{PA3} \\
		Pin NTC & PB1 (AIN10) & \textbf{PA5} (AIN5) \\
		Pin echa & PB0 (AIN11)/PB4 & \textbf{PB4} (przeprowadzony z~PA2) \\
		USART TXD & PA1, \SI{9600}{\baud} & \textbf{PB2, \SI{115200}{\baud}} \\
		Pomiar fazowy (Goertzel) & planowany & \textbf{zaimplementowany} (sek.~\ref{sec:goertzel}) \\
		Detekcja ToF & AC0 capture & ADC obwiednia (czulsza) + AC1 zweryfikowane \\
		Uśpienie & Standby+RTC (plan) & \textbf{zaimplementowane} (Standby+RTC/PIT) \\
		Bramkowanie op-amp (Q1) & Scenariusz 3 (plan) & \textbf{zaimplementowane} \\
		\bottomrule
	\end{tabularx}
\end{table}

\subsection{Uzasadnienie kluczowej korekty (AC0 $\to$ AC1)}

Tabela~5-1 noty katalogowej \textit{ATtiny1614/1616/1617} (DS40002204A, str.~18)
jednoznacznie wskazuje, że pin \texttt{PB4} pełni funkcję \texttt{AINN1}
(wejście \emph{ujemne}) dla komparatora \texttt{AC0}, natomiast funkcję
\texttt{AINP3} (wejście \emph{dodatnie}) dopiero dla komparatora \texttt{AC1}.
Ponieważ sygnał echa wymaga wejścia dodatniego, sprzętowa detekcja musi
korzystać z~\texttt{AC1}. Zgodnie z~architekturą układu (datasheet sek.~29:
,,instance~$n$ of the AC uses instance~$n$ of the DAC'') próg dla \texttt{AC1}
pochodzi z~\texttt{DAC1}, którego referencję ustawiają pola \texttt{DAC1REFSEL}
(\texttt{VREF.CTRLC}) oraz \texttt{DAC1REFEN} (\texttt{VREF.CTRLB}). Korekta ta
była warunkiem uzyskania niezerowych zatrzaśnięć licznika \texttt{TCB0}.

% ══════════════════════════════════════════════════════════════
\section{Dostarczane pliki (deliverables)}
\label{sec:deliverables}

Zgodnie z~wymaganiami Etapu~2 paczka zawiera:

\begin{table}[H]
	\centering
	\caption{Zawartość paczki dostarczanej Komisji}
	\label{tab:deliverables}
	\begin{tabularx}{\textwidth}{lX}
		\toprule
		\textbf{Katalog / plik} & \textbf{Zawartość} \\
		\midrule
		\texttt{firmware/main.c} & Źródło oprogramowania (AVR-GCC, rejestrowo) \\
		\texttt{firmware/main.hex} & Plik wynikowy (Intel HEX) do wgrania przez UPDI \\
		\texttt{firmware/Makefile} & Skrypt budowania i~programowania \\
		\texttt{cad/} & Źródła CAD: \texttt{bezkontaktowy\_miernik\_odległości.sch} + \texttt{.brd} (EAGLE) \\
		\texttt{gerber/} & Komplet Gerber (zip~v17): copper/mask/silk/paste + profil + drill (\texttt{.xln}) + PnP \\
		\texttt{dokumentacja-etap2/} & Niniejsza dokumentacja (\texttt{.tex} + \texttt{.pdf}) \\
		\texttt{*.png} & Rendery PCB i~obudowy, schemat \\
		\bottomrule
	\end{tabularx}
\end{table}

Wszystkie wymagane pliki (prototyp, Gerber, źródła CAD, oprogramowanie
źródłowe i~wynikowe oraz dokumentacja) są kompletne i~dołączone do paczki.
Komplet Gerber wygenerowano zadaniem CAM dla warstw
\texttt{TOP/BOTTOM/soldermask/silkscreen/solderpaste/profile/drill}.

% ══════════════════════════════════════════════════════════════
\section{Dalszy rozwój}
\label{sec:dalsze}

Kierunki dalszego rozwoju prototypu:

\begin{itemize}[nosep]
	\item \textbf{Pełne wykorzystanie fazy do sub-mm} --- etap fazowy (Goertzel)
	jest zaimplementowany i~mierzalnie poprawny ($\sim83^\circ/\si{\milli\metre}$),
	jednak pewny wybór bina $\lambda/2$ wymaga zmniejszenia jittera pomiaru
	zgrubnego poniżej $\lambda/4\approx\SI{2,2}{\milli\metre}$ (obecnie
	${\sim}\SI{4}{\milli\metre}$). Kierunki: silniejszy nadajnik (push-pull),
	uśrednianie fazy z~wielu pingów, interpolacja onsetu.
	\item \textbf{Kalibracja wielopunktowa ($>2$ pkt) / LUT} --- zaimplementowano
	2-punktową kalibrację polową w~EEPROM (sek.~\ref{sec:eeprom}); rozszerzenie
	do LUT z~interpolacją skompensowałoby ewentualną nieliniowość.
	\item \textbf{Sterowanie push-pull nadajnika} (\SI{+6}{\deci\bel} SNR) ---
	wymaga modyfikacji schematu (usunięcie BC817); poprawia SNR ech dalekich.
\end{itemize}

% ══════════════════════════════════════════════════════════════
\section{Podsumowanie}
\label{sec:podsumowanie}

Zbudowany prototyp realizuje bezkontaktowy pomiar odległości w~zakresie
\SIrange{10}{50}{\centi\metre} metodą hybrydową Pulse-Phase Ranging:
pomiar zgrubny Time-of-Flight przez próbkowanie obwiedni echa (ADC) oraz
pomiar fazy nośnej \SI{40}{\kilo\hertz} algorytmem Goertzela, z~kompensacją
temperatury NTC. Dodatkowo zweryfikowano sprzętową ścieżkę detekcji
\texttt{AC1+DAC1+EVSYS+TCB0}. Zaimplementowano agresywne zarządzanie mocą
(Standby + RTC, bramkowanie toru analogowego Q1), co zapewnia średni pobór
mocy poniżej \SI{1}{\milli\watt}. Zmierzony błąd \textbf{RMSE $\approx\SI{2,4}{\milli\metre}$}
($M=35$ odczytów, \SIrange{10}{50}{\centi\metre}), a~faza zmienia się zgodnie
z~teorią ($\sim83^\circ/\si{\milli\metre}$). Wszystkie wymagania konkursowe
(napięcie, zakres, obiekt, koszt) są spełnione.

\end{document}
