KAJPER/WETI/dokumentacja-etap2/WETI_Kacper_Popko_Etap2.pdf

### Ogólnopolski Konkurs Projektowy

### „Wygraj Indeks WETI” — edycja 2026

Wydział Elektroniki, Telekomunikacji i Informatyki Politechnika Gdańska

# Bezkontaktowy miernik odległości

### Metoda hybrydowa Pulse-Phase Ranging z kompensacją temperatury

### Etap 2 — dokumentacja prototypu

Realizacja toru zgrubnego (Time-of-Flight) ze sprzętową, bezlatencyjną detekcją echa

Autor: Kacper Popko
Opiekun: Mateusz Karanowski
Szkoła: II Liceum Ogólnokształcące im. ks. Anny z Sapiehów Jabłonowskiej w Białymstoku E-mail: kacper@kajpa.pl
Data: Czerwiec 2026
Mikrokontroler | ATtiny1616-SN (tinyAVR 1-series)
Metoda | Pulse-Phase Ranging 40 kHz: ToF (obwiednia ADC) + faza (Goertzel)
Zakres | 10 cm – 50 cm
Toolchain | AVR-GCC 15.2 + avrdude 8.1 (czysto rejestrowo)

Bezkontaktowy miernik odległości — Etap 2 (prototyp) | Wygraj Indeks WETI 2026

### Spis treści

1 Wprowadzenie i zakres Etapu 2 | 2
2 Architektura zbudowanego urządzenia | 2
3 Oprogramowanie mikrokontrolera | 3
4 Zarządzanie mocą | 5
5 Wyniki pomiarowe i kalibracja | 5
6 Zmiany względem Etapu 1 | 6
7 Dostarczane pliki (deliverables) | 7
8 Dalszy rozwój | 7
9 Podsumowanie | 8

### 1 Wprowadzenie i zakres Etapu 2

Niniejszy dokument stanowi dokumentację zbudowanego i uruchomionego prototypu bezkontaktowego miernika odległości, dostarczanego w ramach Etapu 2 konkursu „Wygraj Indeks WETI 2026”. W odróżnieniu od dokumentacji Etapu 1 (projekt koncepcyjny) opisuje on rzeczywisty stan urządzenia po montażu, uruchomieniu i strojeniu na stanowisku pomiarowym.

Projekt kontynuuje przyjętą w Etapie 1 metodę hybrydową Pulse-Phase Ranging z kompensacją temperatury. Metoda ta składa się z dwóch etapów: pomiaru zgrubnego czasu przelotu (Time-of-Flight), który eliminuje niejednoznaczność, oraz pomiaru dokładnego fazy echa (algorytm Goertzela), dającego rozdzielczość sub-milimetrową. W prototypie zaimplementowano i uruchomiono oba etapy: pomiar ToF przez próbkowanie obwiedni echa przetwornikiem ADC oraz wyznaczanie fazy nośnej 40 kHz algorytmem Goertzela, a także pełną kompensację temperatury. Zapewnia to poprawny pomiar w całym zakresie 10 cm – 50 cm (sek. 3–5). Dodatkowo zweryfikowano sprzętową, bezlatencyjną ścieżkę detekcji progowej AC1+DAC1+EVSYS+TCB0 (sek. 3.3).

W trakcie realizacji prototypu wprowadzono szereg zmian względem założeń projektowych — wynikających z praktycznej weryfikacji sprzętu oraz z analizy dokumentacji mikrokontrolera. Zmiany te zestawiono w sekcji 6. Najistotniejsza dotyczy ścieżki detekcji echa: pierwotnie zakładano użycie komparatora AC0, jednak weryfikacja Tabeli 5-1 noty katalogowej wykazała, że wejście echa (pin PB4) jest dodatnim wejściem AINP3 komparatora AC1, a nie AC0. Skorygowano to w firmware, dzięki czemu sprzętowa, bezlatencyjna detekcja czasu przelotu działa poprawnie.

### 1.1 Spełnienie wymagań konkursowych

Tabela 1: Status wymagań konkursowych w prototypie

Parametr | Wymóg | Stan w prototypie
Napięcie zasilania | 5 V | Spełnione; LDO MCP1700 → 3,3 V
Zakres pomiaru | 10 cm – 50 cm | Spełnione; potwierdzone pomiarami
Wykrywany obiekt Karton 20 × 20 cm | Spełnione
Błąd RMSE | im mniejszy tym lepiej ≈ 6 mm (metoda ToF, sek. 5)
Pobór mocy | 100/P[mW] | Standby+RTC, Pavg < 1 mW (sek. 4)
Koszt elementów | 2500/C[PLN] | 43,73 PLN → 50 pkt (bez zmian)

### 2 Architektura zbudowanego urządzenia

### 2.1 Schemat blokowy toru sygnałowego

Tor pomiarowy realizuje pomiar czasu przelotu (Time-of-Flight) impulsu ultradźwiękowego 40 kHz:

1. Mikrokontroler generuje paczkę (burst) 40 kHz na pinie PB0, wzmacnianą tranzystorem BC817 sterującym nadajnik US.

2. Echo odbierane przez przetwornik RX jest wzmacniane dwustopniowym torem na MCP6002 (wzmocnienie ∼10×, filtr pasmowy wokół 40 kHz).
3. Wzmocniony sygnał echa (pin PB4 = ADC0 AIN9) jest szybko próbkowany przetwornikiem ADC; z obwiedni wyznaczany jest początek echa (czas przelotu), a z przebiegu — faza nośnej (Goertzel).
4. Niezależnie ten sam sygnał trafia na komparator AC1 (próg z DAC1) → EVSYS → TCB0 — zweryfikowana, sprzętowa, bezlatencyjna ścieżka detekcji progowej.
5. Temperatura z termistora NTC koryguje prędkość dźwięku; odległość D = c(T) · tToF /2.

### 2.2 Mapa pinów ATtiny1616 (stan rzeczywisty)

Tabela 2 przedstawia faktyczne przyporządkowanie pinów w zbudowanym prototypie. Różni się ono od wstępnego projektu (Etap 1) — zmiany wynikły z optymalizacji rozprowadzenia ścieżek PCB oraz z korekty przypisania komparatora (patrz sek. 6).

Tabela 2: Mapa pinów ATtiny1616 w prototypie

Pin | Funkcja | Opis / peryferiał
PA0 | UPDI | Programowanie / debug
PA3 | PRZYCISK | Wejście, pull-up, aktywny stan niski (start pomiaru)
PA4 | LED | Wyjście, sygnalizacja pomiaru
PA5 | TERMISTOR | ADC0 AIN5 (kompensacja temperatury, NTC 10 kΩ)
PA6 | GATE Q1 | Sterowanie P-MOSFET BSS84 (zasilanie toru RX)
PB0 TX BURST | Generacja 40 kHz (programowa) → R1 → BC817
PB2 USART0 TXD Transmisja wyniku, 115 200 Bd 8N1
PB4 ECHO | AC1 AINP3 (wyjście toru RX → komparator)

### 3 Oprogramowanie mikrokontrolera

Firmware napisano w języku C, kompilowany AVR-GCC 15.2 (bez frameworka Arduino), wgrywany przez avrdude 8.1 interfejsem UPDI. Konfiguracja peryferiów odbywa się na poziomie rejestrowym. Plik źródłowy: firmware/main.c; plik wynikowy: firmware/main.hex (∼ 6,4 kB Flash z 16 kB, 332 B RAM).

### 3.1 Pomiar ToF przez próbkowanie obwiedni (ADC)

Właściwy pomiar odległości realizowany jest przez szybkie próbkowanie sygnału echa przetwornikiem ADC (pin PB4 = ADC0 AIN9, tryb 8-bit, prescaler DIV4, ∼8,7 µs/próbkę ≈ 115 ksps, tj. ∼2,9 próbki na okres 40 kHz). Minimalna pętla próbkująca zapisuje 320 próbek do bufora; czas trwania okna jest mierzony licznikiem TCB0 (100 ns/takt), co daje dokładną podstawę czasu.

W post-processingu wyznaczany jest początek echa (onset) — pierwsza próbka przekraczająca próg ONSET_DEV — którego czas odpowiada rzeczywistemu czasowi przelotu: D = c(T) · tonset/2. Metoda obwiedni jest odporna na amplitudę (wykrywa też słabe echa z 40 cm), a zapisany bufor próbek służy następnie etapowi fazowemu (Goertzel). Detekcja przez ADC okazała się czulsza od progowej ścieżki sprzętowej (sek. 3.3) i dodatkowo dostarcza przebiegu potrzebnego do pomiaru fazy — dlatego przyjęto ją jako podstawową.

### 3.2 Pomiar fazy — algorytm Goertzela

Na buforze próbek echa uruchamiany jest filtr Goertzela dostrojony do 40 kHz, liczący część rzeczywistą i urojoną prążka DFT, a stąd amplitudę i fazę nośnej. Faza odniesiona do startu burstu (przez dodanie członu f0 · tokna) koduje pozycję obiektu w obrębie λ/2 ≈ 4,33 mm:

D
λ/2

= f0 tToF = f0 tokna +

φ0 − φ
2π
. | (1)

Wynik łączony jest ze zgrubnym ToF: D = n·(λ/2)+Dfaza, gdzie n wynika z pomiaru zgrubnego, z kontrolą spójności (odrzucenie skoków o pół fali). Pomiarowo zweryfikowano, że faza zmienia się ∼83

◦/mm zgodnie z teorią i jest powtarzalna przy stałej odległości.

### 3.3 Zweryfikowana sprzętowa ścieżka detekcji (AC1+TCB0)

Niezależnie zaimplementowano i zweryfikowano w pełni sprzętową, bezlatencyjną ścieżkę detekcji progowej, nieobciążającą rdzenia CPU. Łańcuch zdarzeń (datasheet sek. 14 i 29):

Tabela 3: Konfiguracja rejestrów ścieżki detekcji echa

Peryferiał | Konfiguracja | Znaczenie
VREF | CTRLC: DAC1REFSEL=2V5 | Referencja 2,5 V dla DAC1/AC1 (≤ VDD)
| CTRLB: DAC1REFEN=1 | Wymuszone włączenie referencji
DAC1 | DATA=255, ENABLE=1 | Próg detekcji ≈ 2,49 V (tuż pod VG)
AC1 | MUXPOS=AINP3 (PB4) | Wejście dodatnie = echo
| MUXNEG=DAC | Wejście ujemne = próg DAC1
| ENABLE=1, HYSMODE=10mV | Histereza 10 mV
EVSYS | ASYNCCH0=AC1_OUT | Źródło: wyjście AC1
| ASYNCUSER0=ASYNCCH0 | Odbiorca: TCB0 (input capture)
TCB0 | CNTMODE=CAPT, CAPTEI=1 | Zatrzask licznika na zboczu zdarzenia
| CLKSEL=CLKDIV1 | 10 MHz, 100 ns/takt

Próg detekcji jest ustawiony tuż poniżej napięcia spoczynkowego toru VG ≈ 2,69 V. W stanie spoczynku VP B4 > VDAC1, więc AC1 ma stabilny stan wysoki. Echo wywołuje oscylacje, których ujemne półfale schodzą poniżej progu — każde przejście w górę generuje zbocze narastające, zatrzaskiwane przez TCB0. Pierwsze prawidłowe zatrzaśnięcie po czasie blankingu odpowiada nadejściu echa.

### 3.4 Algorytm pomiaru

1. Wybudzenie z uśpienia (Standby), włączenie toru analogowego (Q1 ON), stabilizacja 5 ms.
2. Odczyt temperatury z NTC (ADC 10-bit), obliczenie c(T) = 331,3 + 0,606 T [m/s].
3. Burst TX N = 10 cykli 40 kHz (12,5 µs półokres → dokładny rezonans przetwornika).
4. Blanking (pominięcie ring-downu), szybkie próbkowanie obwiedni echa (ADC 8-bit, 320 próbek) → onset → zgrubne D (sek. 3.1).
5. Seria M = 9 pomiarów, filtr medianowy → odporne Dcoarse.

6. Goertzel na buforze ostatniego pingu → faza → fuzja D = n · (λ/2) + Dfaza z kontrolą spójności (sek. 3.2).
7. Kalibracja liniowa D = a·Draw+b, transmisja przez USART, flush TX, powrót do uśpienia.

### 3.5 Kompensacja temperatury

Termistor NTC 10 kΩ (B = 3950) w dzielniku z rezystorem 10 kΩ do masy. Rezystancja RNTC = R10 · (1023 − ADC)/ADC; temperatura z modelu Beta:

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
RNTC

R25

, | T0 = 298,15 K. | (2)

Prędkość dźwięku skalowana liniowo z temperaturą eliminuje dominujący błąd systematyczny (zmiana ∼ 0,17 %/K).

### 4 Zarządzanie mocą

Prototyp realizuje agresywną politykę uśpienia zapowiedzianą w Etapie 1 (Scenariusz 2/3):

- Tryb Standby mikrokontrolera między pomiarami — rdzeń CPU i większość peryferiów zatrzymane.
- Wybudzanie z RTC/PIT co 125 ms (licznik PIT taktowany wewnętrznym oscylatorem ULP 32,768 kHz); po wybudzeniu odpytywany jest przycisk.
- Bramkowanie toru analogowego tranzystorem Q1 (BSS84) — wzmacniacz MCP6002
jest zasilany wyłącznie podczas pomiaru (∼ 30 ms), w spoczynku pobiera 0 µA.
- ADC i AC włączane na żądanie; nieużywane bufory wejściowe pinów wyłączone (INPUT_DISABLE).

W stanie spoczynku pobór prądu jest zdominowany przez oscylator ULP RTC (∼ 1 µA−−3 µA).
Przy typowym użyciu (pomiar na żądanie) średni pobór mocy nie przekracza 1 mW, co odpowiada maksymalnej punktacji (50 pkt) w kryterium mocy.

Tabela 4: Bilans prądowy (zmierzony / szacowany)

Stan | Prąd | Uwaga
Pomiar aktywny (op-amp + MCU + ADC) | ∼ 4,3 mA zmierzone (5 V, INA219)
Spoczynek bez uśpienia (tylko bramkowanie) | ∼ 3,2 mA | zmierzone
Spoczynek Standby+RTC | ∼ 1 µA − −3 µA | szac. (ULP osc + RTC)

### 5 Wyniki pomiarowe i kalibracja

Pomiary wykonano kartonem 20 × 20 cm ustawionym prostopadle do osi przetworników, na czystej ścianie. Po kalibracji liniowej (D = a · Draw + b) uzyskano zgodność z miarą wzorcową w całym zakresie 10 cm – 50 cm.

Tabela 5: Przykładowa charakterystyka po kalibracji (metoda peak/ToF)

Odl. rzecz. [mm] Odczyt śr. [mm] Błąd [mm] σ [mm]

100 | 104 | +4 | 4,4
150 | 159 | +9 | 0,0
200 | 191 | −9 | 0,0
300 | 305 | +5 | 5,7
400 | 401 | +1 | 4,0
500 | 498 | −2 | 4,5

Błąd średniokwadratowy z powyższych punktów:

RMSE =

s
1
n

X

i

(Di − Di,ref )

2 ≈ 5,9 mm. | (3)

Powtarzalność (odchylenie standardowe serii pomiarów dla stałej odległości) wynosi σ ≈ 4 mm, a liniowość charakterystyki R² > 0,999. Podstawa czasu TCB0 (100 ns/takt) nie ogranicza roz-

dzielczości — limitują ją czynniki analogowe (czas narastania obwiedni echa). Etap fazowy (Goertzel) zmienia się ∼83

◦/mm zgodnie z teorią (360

- na λ/2 ≈ 4,33 mm) i jest powtarzalny przy

stałej odległości; pełne wykorzystanie do sub-mm ogranicza obecnie jitter pomiaru zgrubnego (sek. 8).

### 6 Zmiany względem Etapu 1

Tabela 6: Rozbieżności projekt (Etap 1) vs. prototyp (Etap 2)

Element | Etap 1 (projekt) | Etap 2 (prototyp)
Komparator echa | AC0, próg z DAC0 | AC1, | próg | z | DAC1
(PB4=AINP3 | jest | na | AC1,
nie AC0 — Tab. 5-1)
Generacja TX | TCA0 WO5 (sprzęt. PWM, PA5) | Programowe taktowanie burstu na
| | PB0
Pin LED | PC0 | PA4
Pin przycisku | PA7 | PA3
Pin NTC | PB1 (AIN10) | PA5 (AIN5)
Pin echa | PB0 (AIN11)/PB4 | PB4 (przeprowadzony z PA2)
USART TXD | PA1, 9600 Bd | PB2, 115 200 Bd
Pomiar | fazowy
(Goertzel)
planowany | zaimplementowany (sek. 3.2)
Detekcja ToF | AC0 capture | ADC obwiednia (czulsza) + AC1
zweryfikowane
Uśpienie | Standby+RTC (plan) | zaimplementowane
(Standby+RTC/PIT)
Bramkowanie op-amp (Q1)
Scenariusz 3 (plan) | zaimplementowane

### 6.1 Uzasadnienie kluczowej korekty (AC0 → AC1)

Tabela 5-1 noty katalogowej ATtiny1614/1616/1617 (DS40002204A, str. 18) jednoznacznie wskazuje, że pin PB4 pełni funkcję AINN1 (wejście ujemne) dla komparatora AC0, natomiast funkcję AINP3 (wejście dodatnie) dopiero dla komparatora AC1. Ponieważ sygnał echa wymaga wejścia dodatniego, sprzętowa detekcja musi korzystać z AC1. Zgodnie z architekturą układu (datasheet sek. 29: „instance n of the AC uses instance n of the DAC”) próg dla AC1 pochodzi z DAC1, którego referencję ustawiają pola DAC1REFSEL (VREF.CTRLC) oraz DAC1REFEN (VREF.CTRLB). Korekta ta była warunkiem uzyskania niezerowych zatrzaśnięć licznika TCB0.

### 7 Dostarczane pliki (deliverables)

Zgodnie z wymaganiami Etapu 2 paczka zawiera:

Tabela 7: Zawartość paczki dostarczanej Komisji

Katalog / plik | Zawartość
firmware/main.c | Źródło oprogramowania (AVR-GCC, rejestrowo)
firmware/main.hex | Plik wynikowy (Intel HEX) do wgrania przez UPDI
firmware/Makefile | Skrypt budowania i programowania
cad/ | Źródła CAD: bezkontaktowy_miernik_odległości.sch + .brd
| (EAGLE)
gerber/ | Komplet Gerber (zip v17): copper/mask/silk/paste + profil + drill
| (.xln) + PnP
dokumentacja-etap2/ Niniejsza dokumentacja (.tex + .pdf)
*.png | Rendery PCB i obudowy, schemat

Wszystkie wymagane pliki (prototyp, Gerber, źródła CAD, oprogramowanie źródłowe i wynikowe oraz dokumentacja) są kompletne i dołączone do paczki. Komplet Gerber wygenerowano zada-

niem CAM dla warstw TOP/BOTTOM/soldermask/silkscreen/solderpaste/profile/drill.

### 8 Dalszy rozwój

Kierunki dalszego rozwoju prototypu:

- Pełne wykorzystanie fazy do sub-mm — etap fazowy (Goertzel) jest zaimplementowany i mierzalnie poprawny (∼ 83

◦/mm), jednak pewny wybór bina λ/2 wymaga zmniej-

szenia jittera pomiaru zgrubnego poniżej λ/4 ≈ 2,2 mm (obecnie ∼4 mm). Kierunki: silniejszy nadajnik (push-pull), uśrednianie fazy z wielu pingów, interpolacja onsetu.
- Kalibracja wielopunktowa w EEPROM — obecnie kalibracja liniowa (dwa współczynniki w firmware).
- Sterowanie push-pull nadajnika (6 dB SNR) — wymaga modyfikacji schematu (usunięcie BC817); poprawia SNR ech dalekich.

### 9 Podsumowanie

Zbudowany prototyp realizuje bezkontaktowy pomiar odległości w zakresie 10 cm – 50 cm metodą hybrydową Pulse-Phase Ranging: pomiar zgrubny Time-of-Flight przez próbkowanie obwiedni echa (ADC) oraz pomiar fazy nośnej 40 kHz algorytmem Goertzela, z kompensacją temperatury NTC. Dodatkowo zweryfikowano sprzętową ścieżkę detekcji AC1+DAC1+EVSYS+TCB0. Zaimplementowano agresywne zarządzanie mocą (Standby + RTC, bramkowanie toru analogowego Q1), co zapewnia średni pobór mocy poniżej 1 mW. Pomiar jest stabilny i powtarzalny (σ ≈ 4 mm), a faza zmienia się zgodnie z teorią (∼ 83

◦/mm). Wszystkie wymagania konkursowe (napięcie,

zakres, obiekt, koszt) są spełnione.
