KAJPER/WETI/dokumentacja-etap2/foto/obudowa_spod.jpg

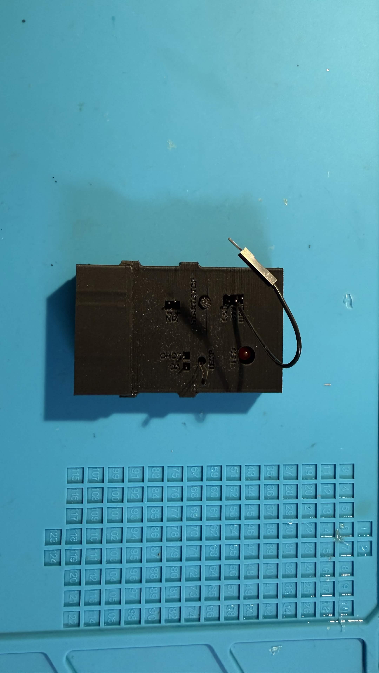
dokumentacja-etap2/foto/obudowa_spod.jpg
