KAJPER/WETI/dokumentacja-etap2/foto/pcb_goly_gora.jpg

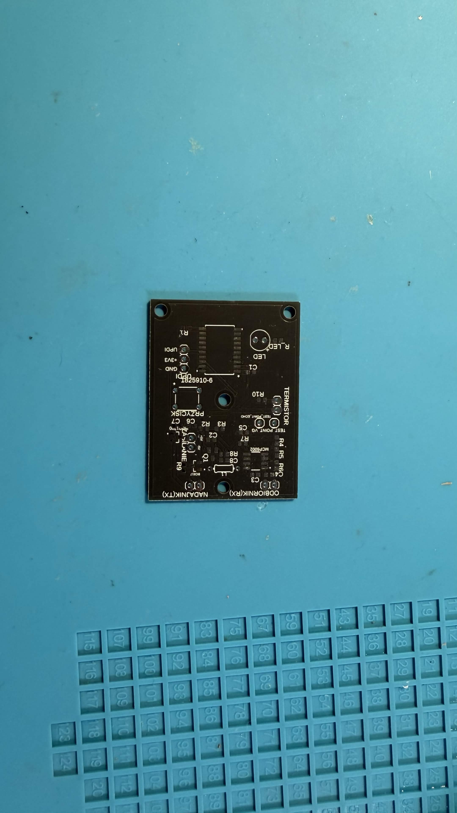
dokumentacja-etap2/foto/pcb_goly_gora.jpg
