KAJPER/WETI/dokumentacja-etap2/foto/pcb_goly_kat.jpg

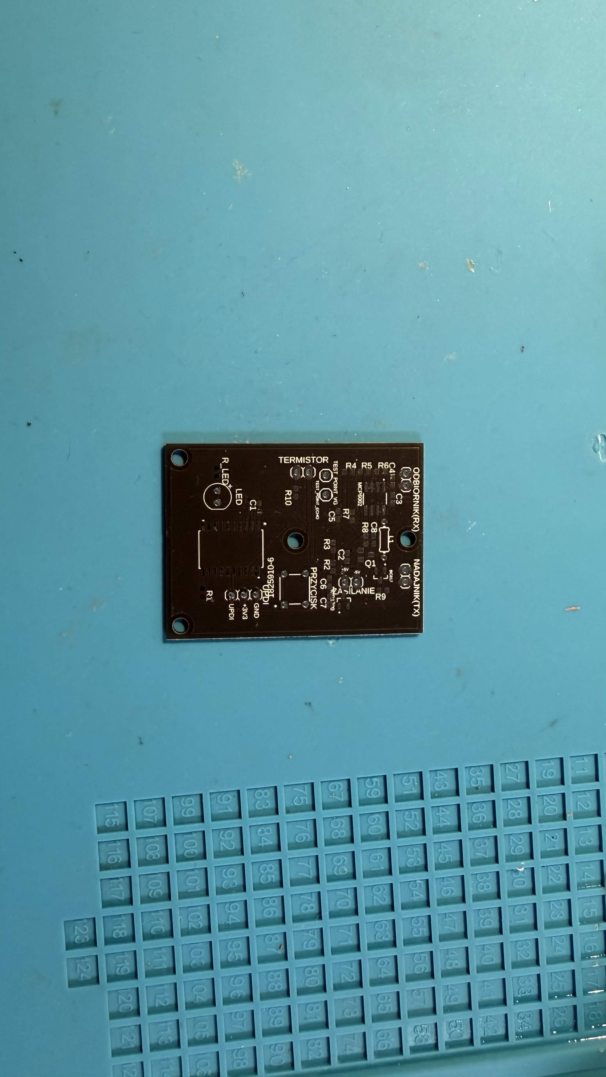
dokumentacja-etap2/foto/pcb_goly_kat.jpg
