KAJPER/WETI/dokumentacja-etap2/foto/plytka_bok.jpg

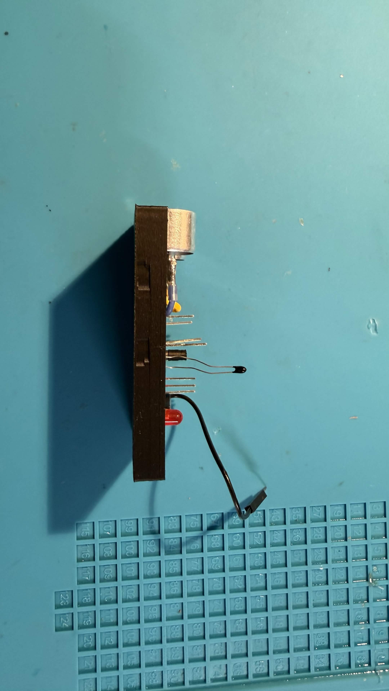
dokumentacja-etap2/foto/plytka_bok.jpg
