KAJPER/WETI/obudowa/otwarta/1.png

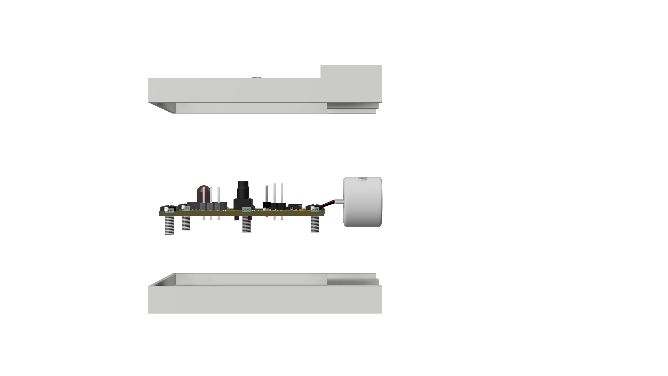
obudowa/otwarta/1.png
