KAJPER/WETI/obudowa/otwarta/2.png

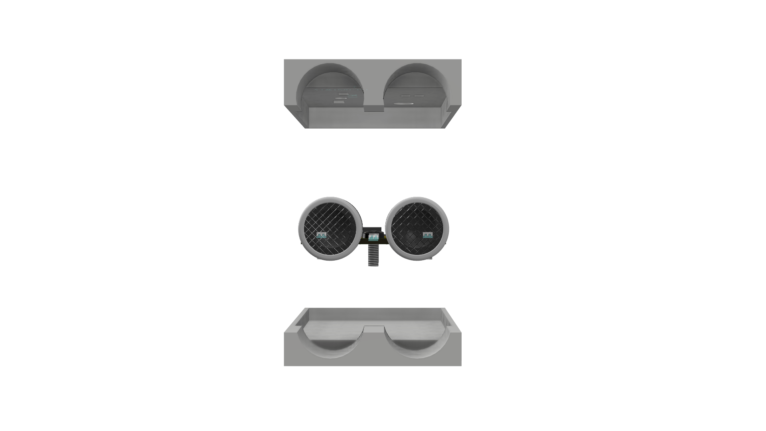
obudowa/otwarta/2.png
