KAJPER/WETI/obudowa/otwarta/3.png

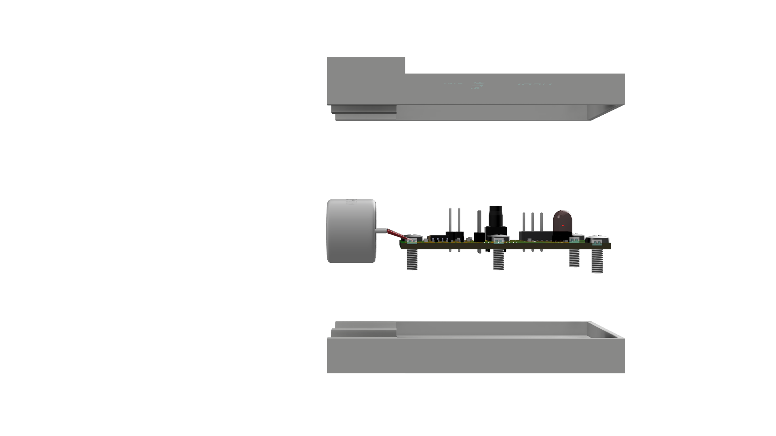
obudowa/otwarta/3.png
