KAJPER/WETI/obudowa/otwarta/4.png

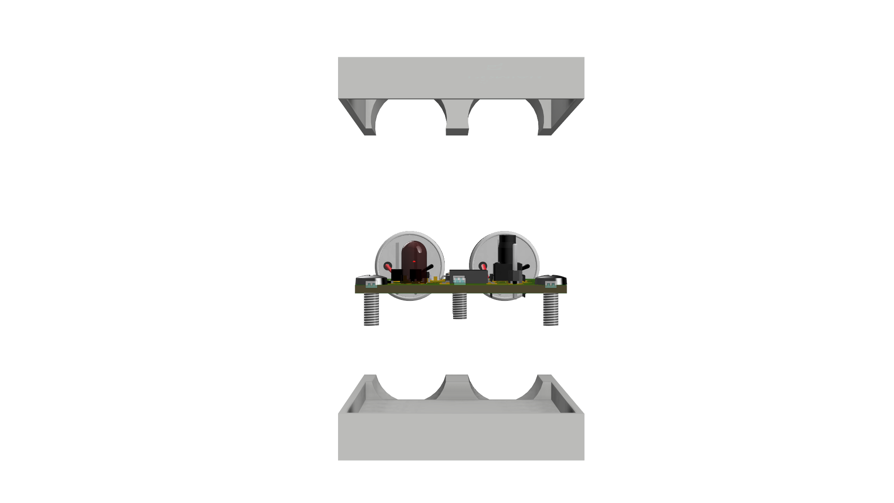
obudowa/otwarta/4.png
