KAJPER/WETI/obudowa/otwarta/5.png

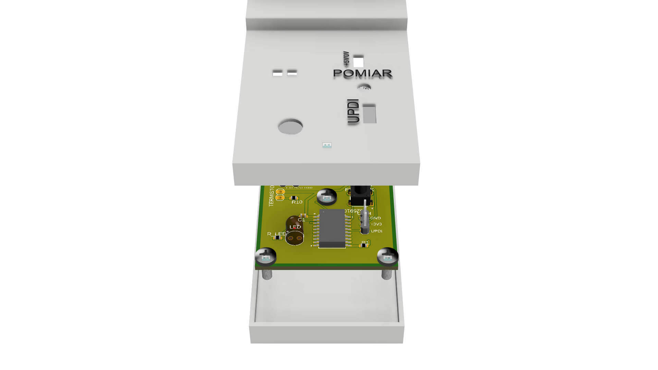
obudowa/otwarta/5.png
