KAJPER/WETI/obudowa/otwarta/6.png

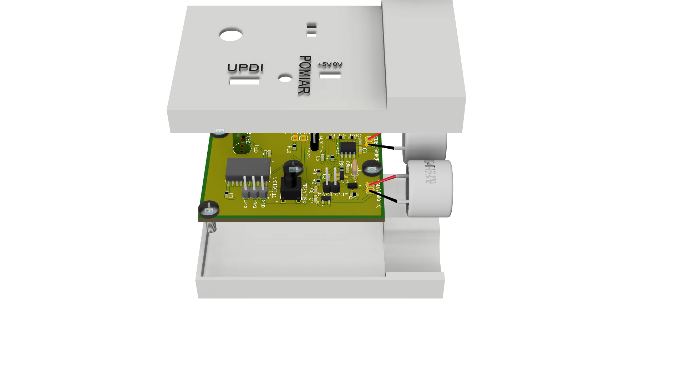
obudowa/otwarta/6.png
