KAJPER/WETI/obudowa/zamknieta/1 (4).png

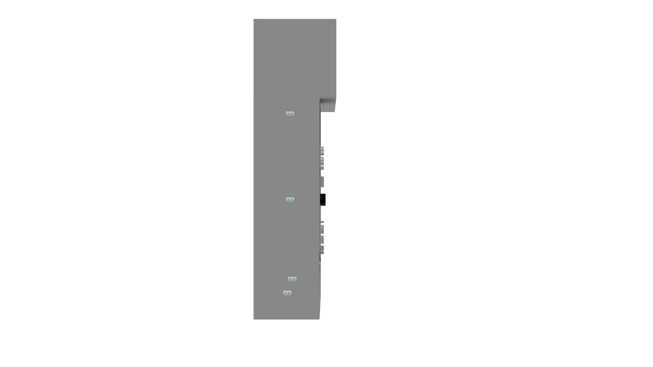
obudowa/zamknieta/1 (4).png
