KAJPER/WETI/obudowa/zamknieta/1 (5).png

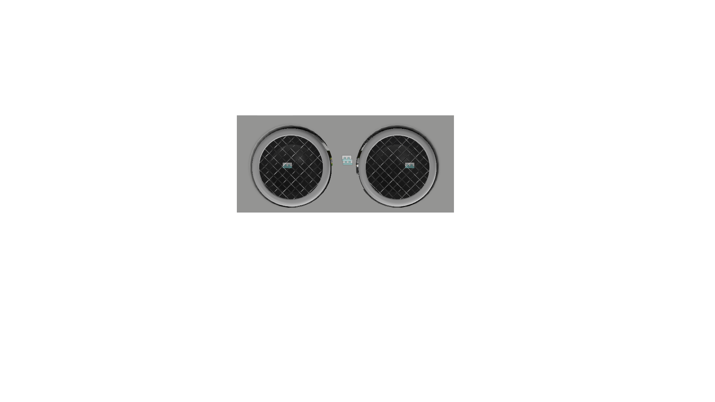
obudowa/zamknieta/1 (5).png
