KAJPER/WETI/obudowa/zamknieta/1 (6).png

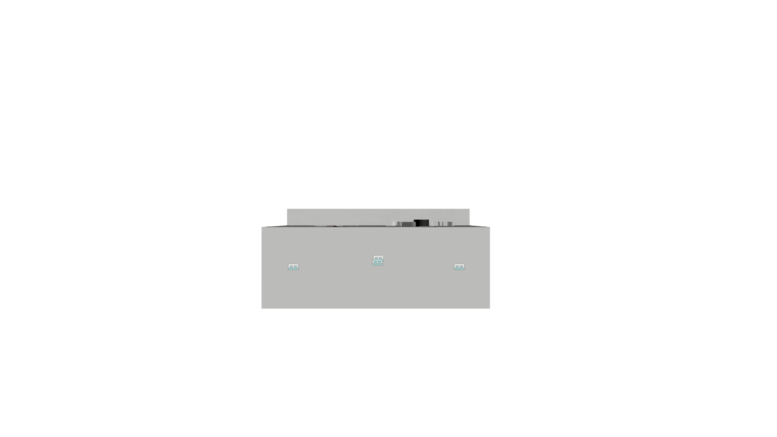
obudowa/zamknieta/1 (6).png
