KAJPER/WETI/obudowa/zamknieta/1 (7).png

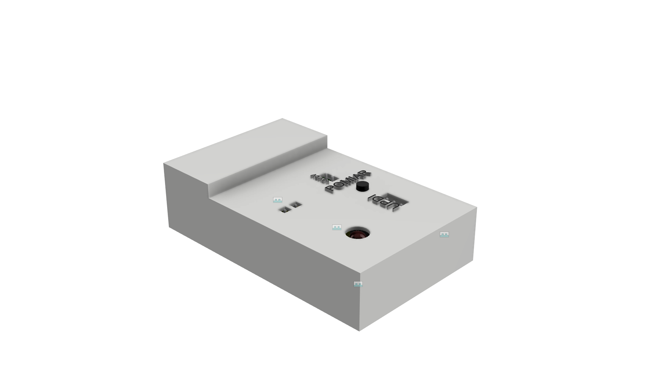
obudowa/zamknieta/1 (7).png
