KAJPER/WETI/obudowa/zamknieta/1 (8).png

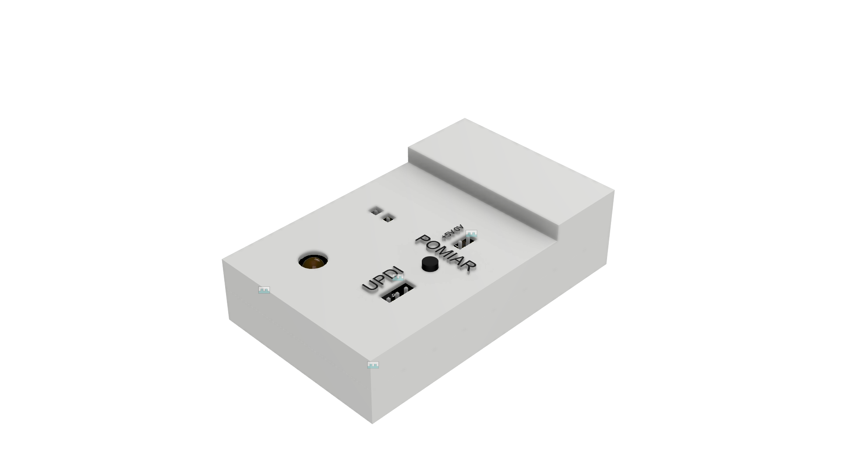
obudowa/zamknieta/1 (8).png
