KAJPER/WETI/obudowa/zamknieta/1 (9).png

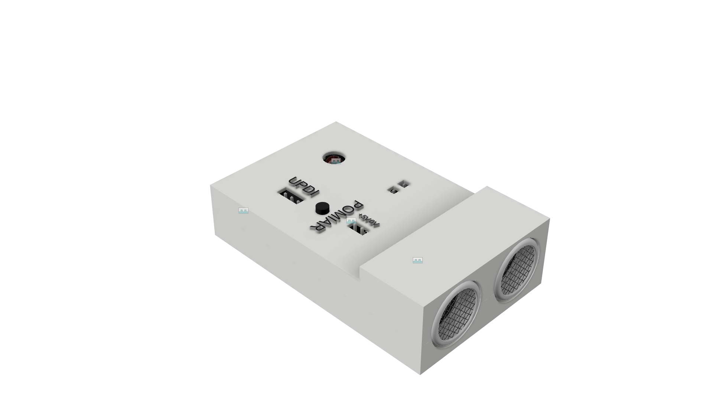
obudowa/zamknieta/1 (9).png
