KAJPER/WETI/obudowa/zamknieta/1 (10).png

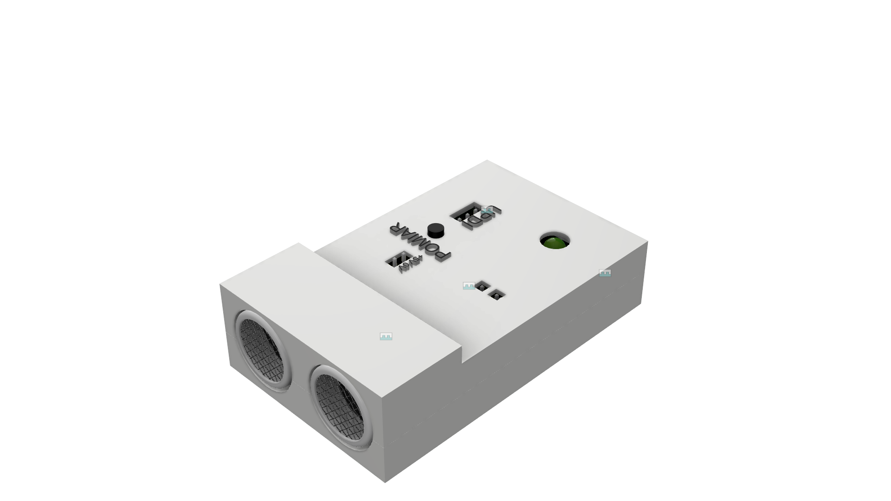
obudowa/zamknieta/1 (10).png
