KAJPER/WETI/prezentacja/WETI_prezentacja.pdf

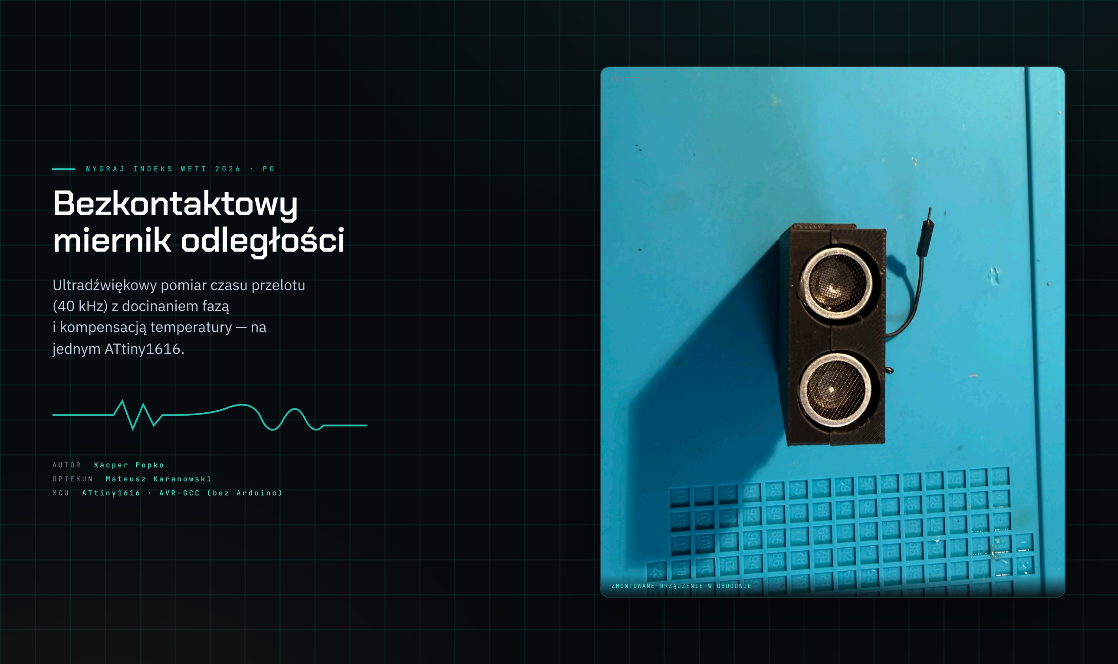
[picture p30: page 1]

W Y G R A J | I N D E K S | W E T I | 2 0 2 6 | · | P G

# Bezkontaktowy miernik odległości

## Ultradźwiękowy pomiar czasu przelotu (40 kHz) z docinaniem fazą i kompensacją temperatury — na

jednym ATtiny1616.

A U T O R | K a c p e r | P o p k o
O P I E K U N | M a t e u s z | K a r a n o w s k i
M C U | A T t i n y 1 6 1 6 | · | A V R - G C C | ( b e z | A r d u i n o )

P R O T O T Y P

ZMONTOWANE | URZĄDZENIE | W | OBUDOWIE

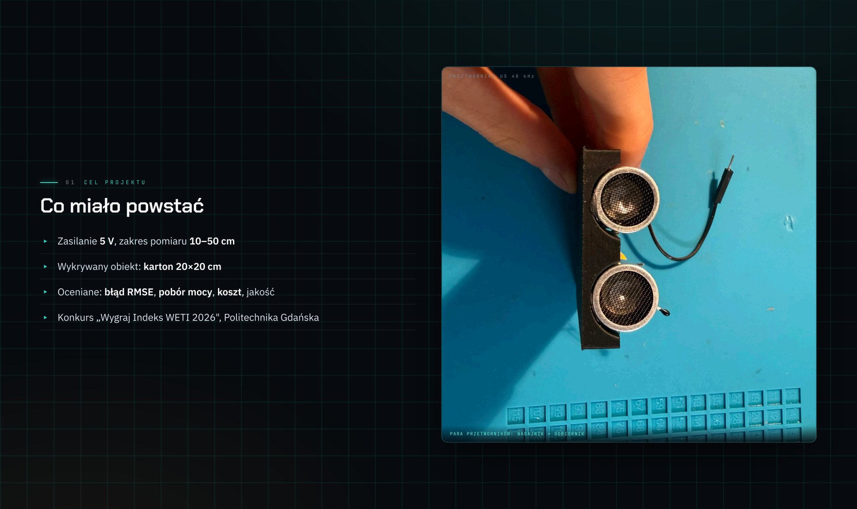
[picture p31: page 2]
PARA; PRZETWORNIKÓW:; NADAJNIK; ODBIORNIK

Co miało powstać

▸ Zasilanie 5 V, zakres pomiaru 10–50 cm

▸ Wykrywany obiekt: karton 20×20 cm

▸ Oceniane: błąd RMSE, pobór mocy, koszt, jakość

▸ Konkurs „Wygraj Indeks WETI 2026", Politechnika Gdańska

0 2 | W Y B Ó R | M E T O D Y

# Dlaczego Pulse-Phase Ranging

METODA | RMSE | KOSZT | UWAGA
Prosty ToF (US) | ~3 mm | niski | ograniczony obwiednią
Pulse-Phase (US) ★ | ~0,5 mm | niski | ToF + faza — wybrany kompromis
FMCW chirp | <0,5 mm | średni | za duże zasoby na ATtiny
Triangulacja optyczna | ~1 mm | średni | wrażliwa na światło

Wybór: tanie przetworniki rezonansowe, dokładność sub-mm w zasięgu ATtiny1616, odporność na kolor i oświetlenie obiektu.

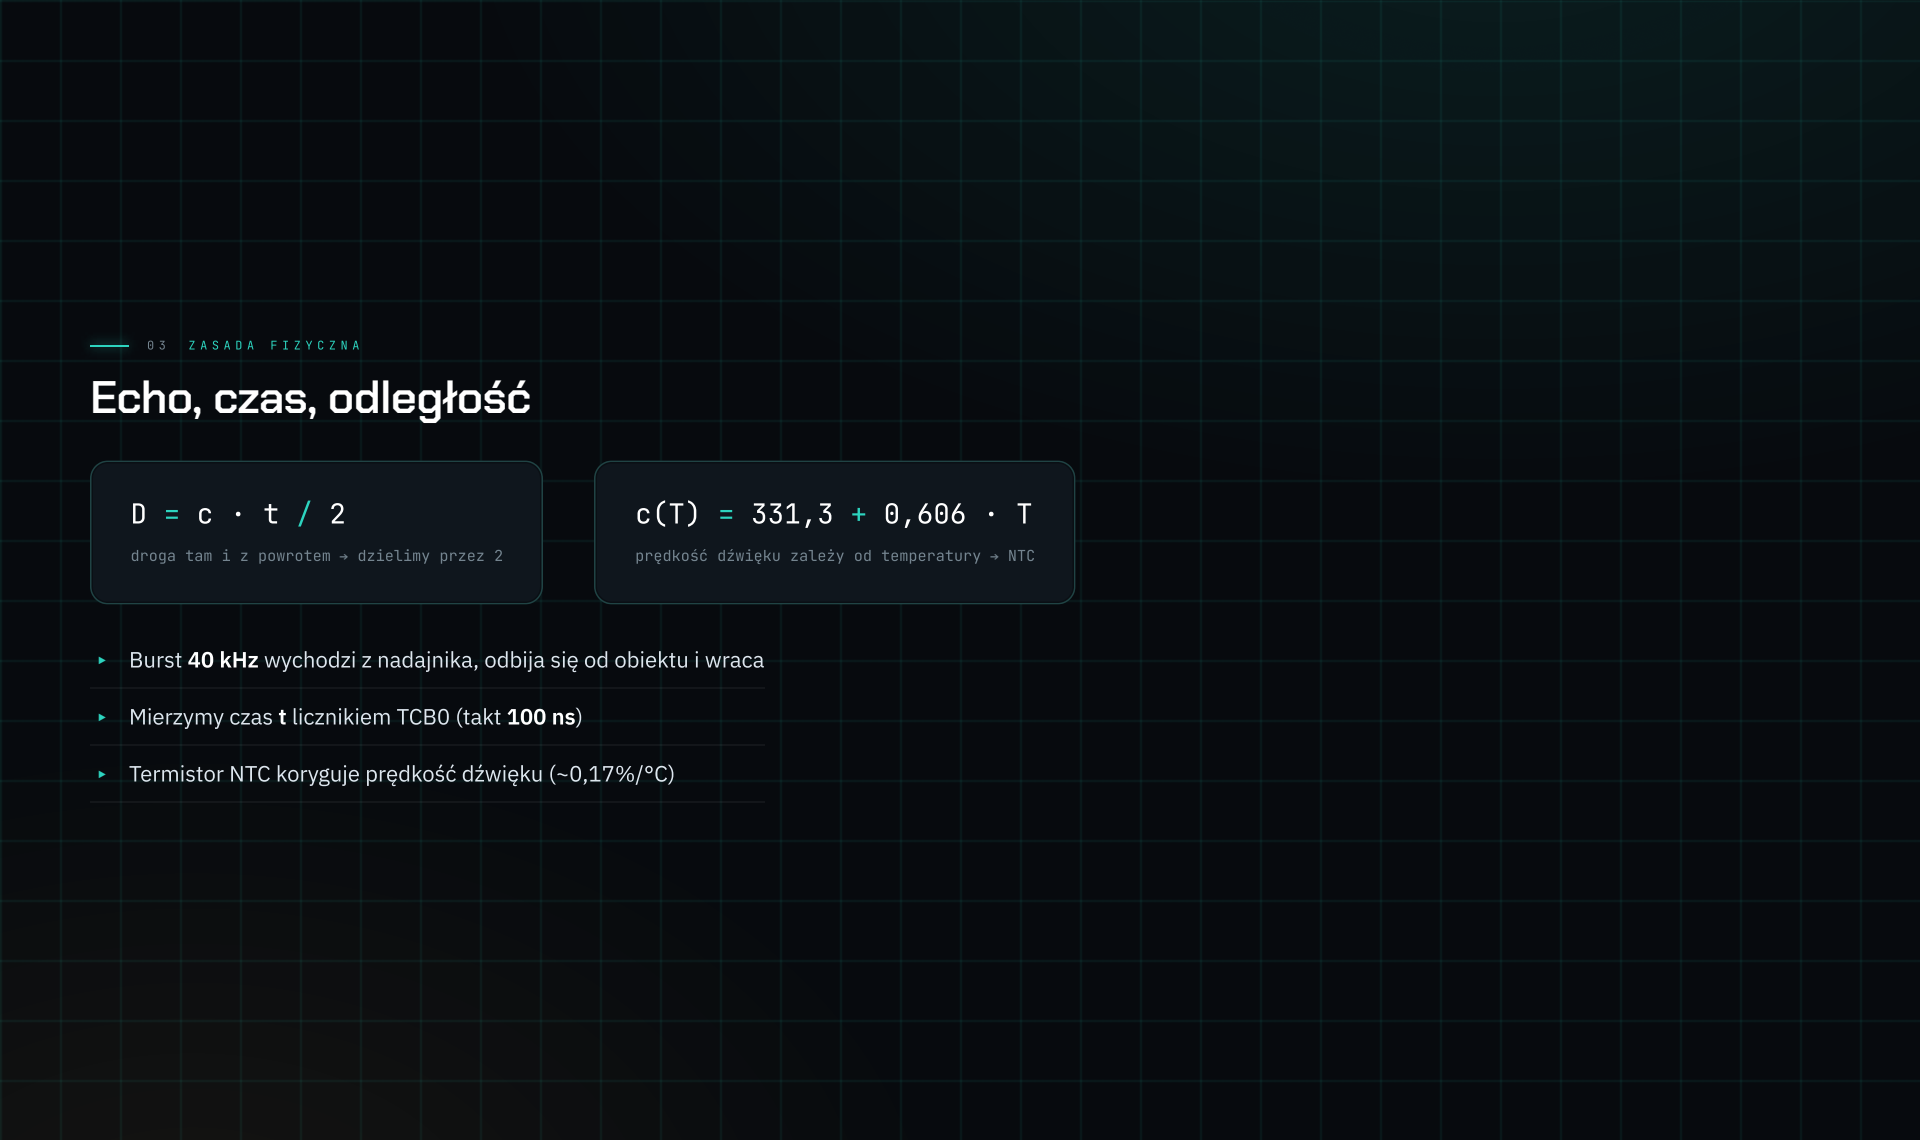
[picture p32: page 4]

Echo, czas, odległość

droga tam i z powrotem → dzielimy przez 2

prędkość dźwięku zależy od temperatury → NTC

▸ Burst 40 kHz wychodzi z nadajnika, odbija się od obiektu i wraca

▸ Mierzymy czas t licznikiem TCB0 (takt 100 ns)

▸ Termistor NTC koryguje prędkość dźwięku (~0,17%/°C)

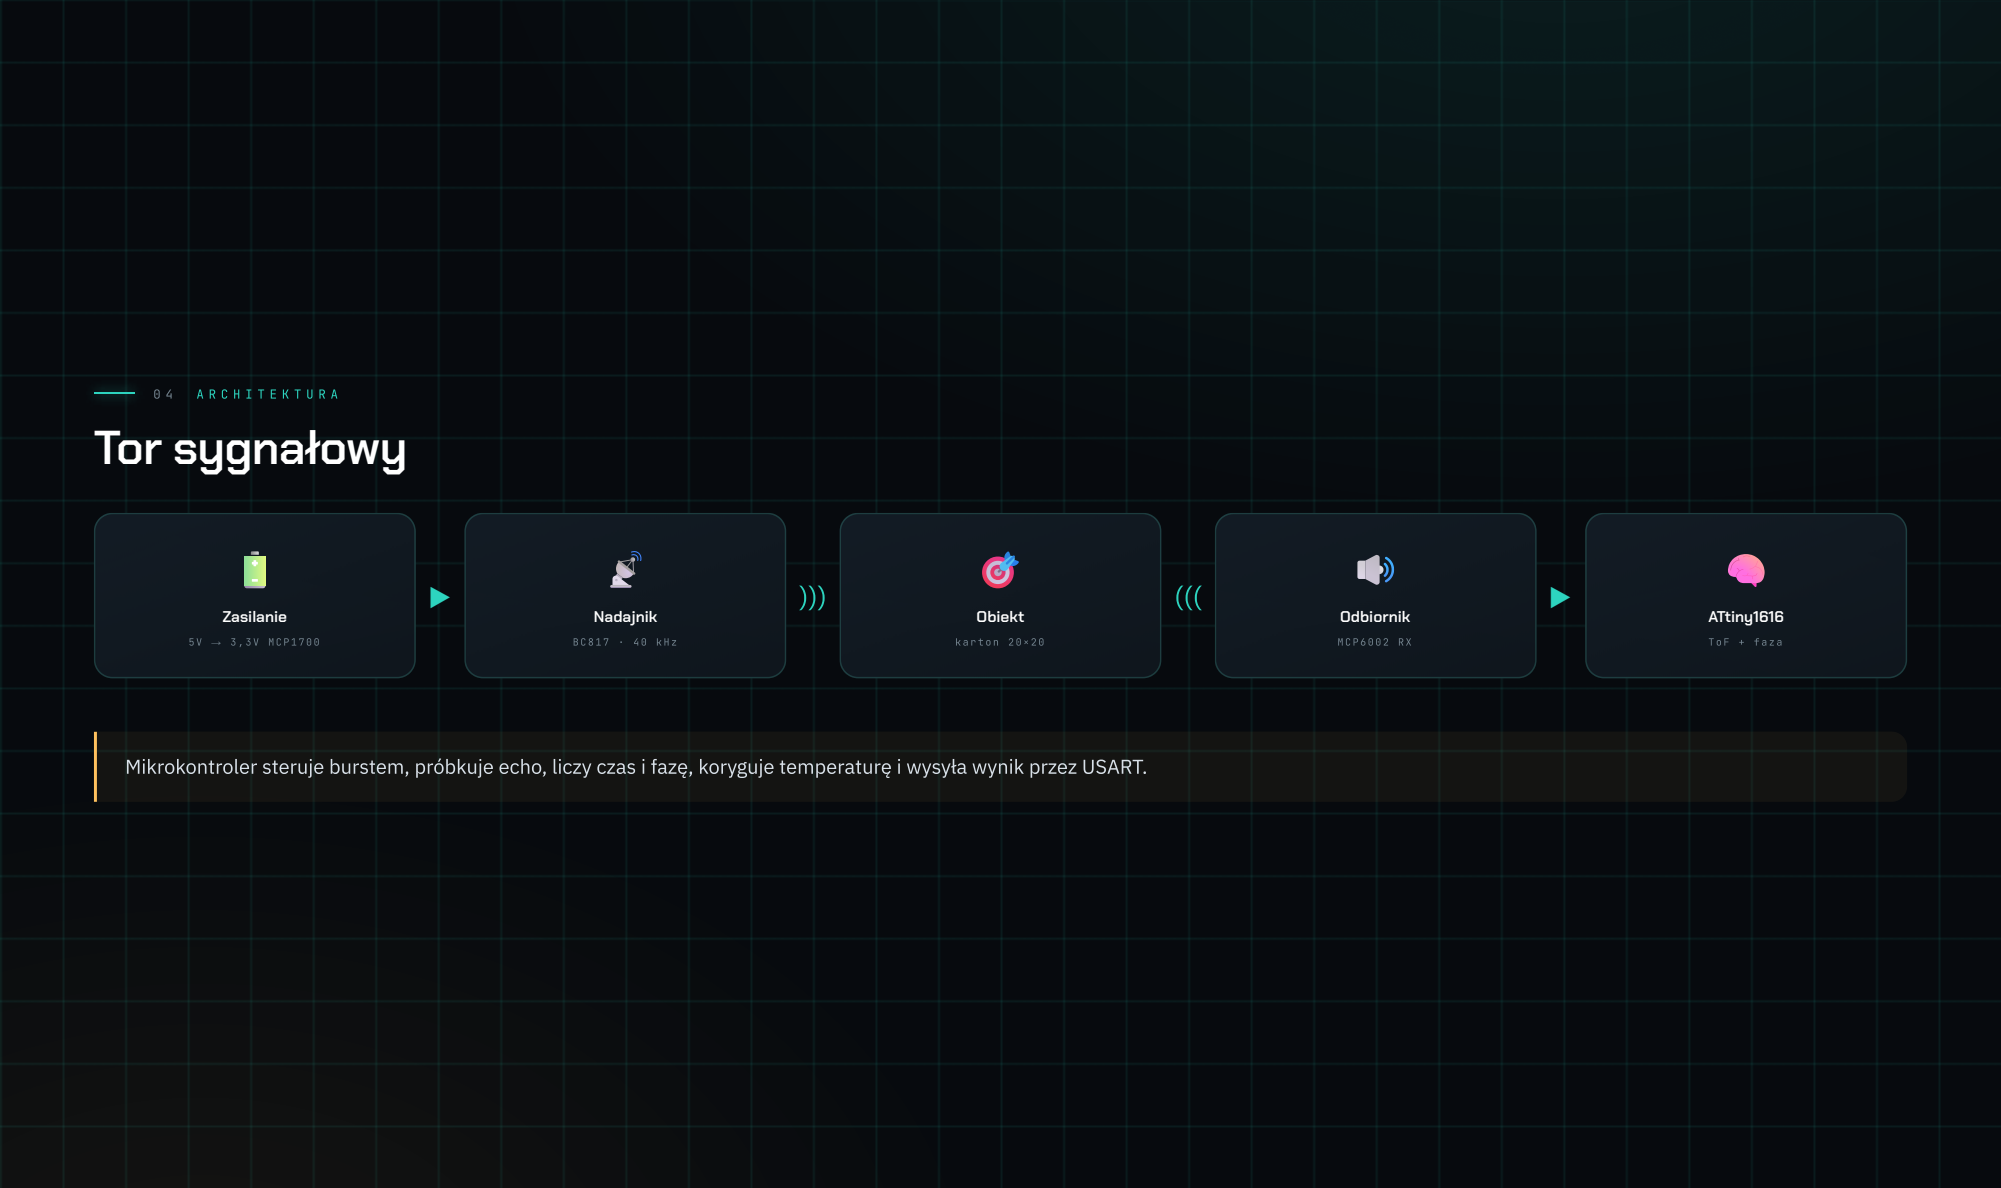
[picture p33: page 5]
Tor sygnałowy; Zasilanie; Nadajnik; Obiekt; Odbiornik; ATtiny1616

Mikrokontroler steruje burstem, próbkuje echo, liczy czas i fazę, koryguje temperaturę i wysyła wynik przez USART.

# Schemat ideowy

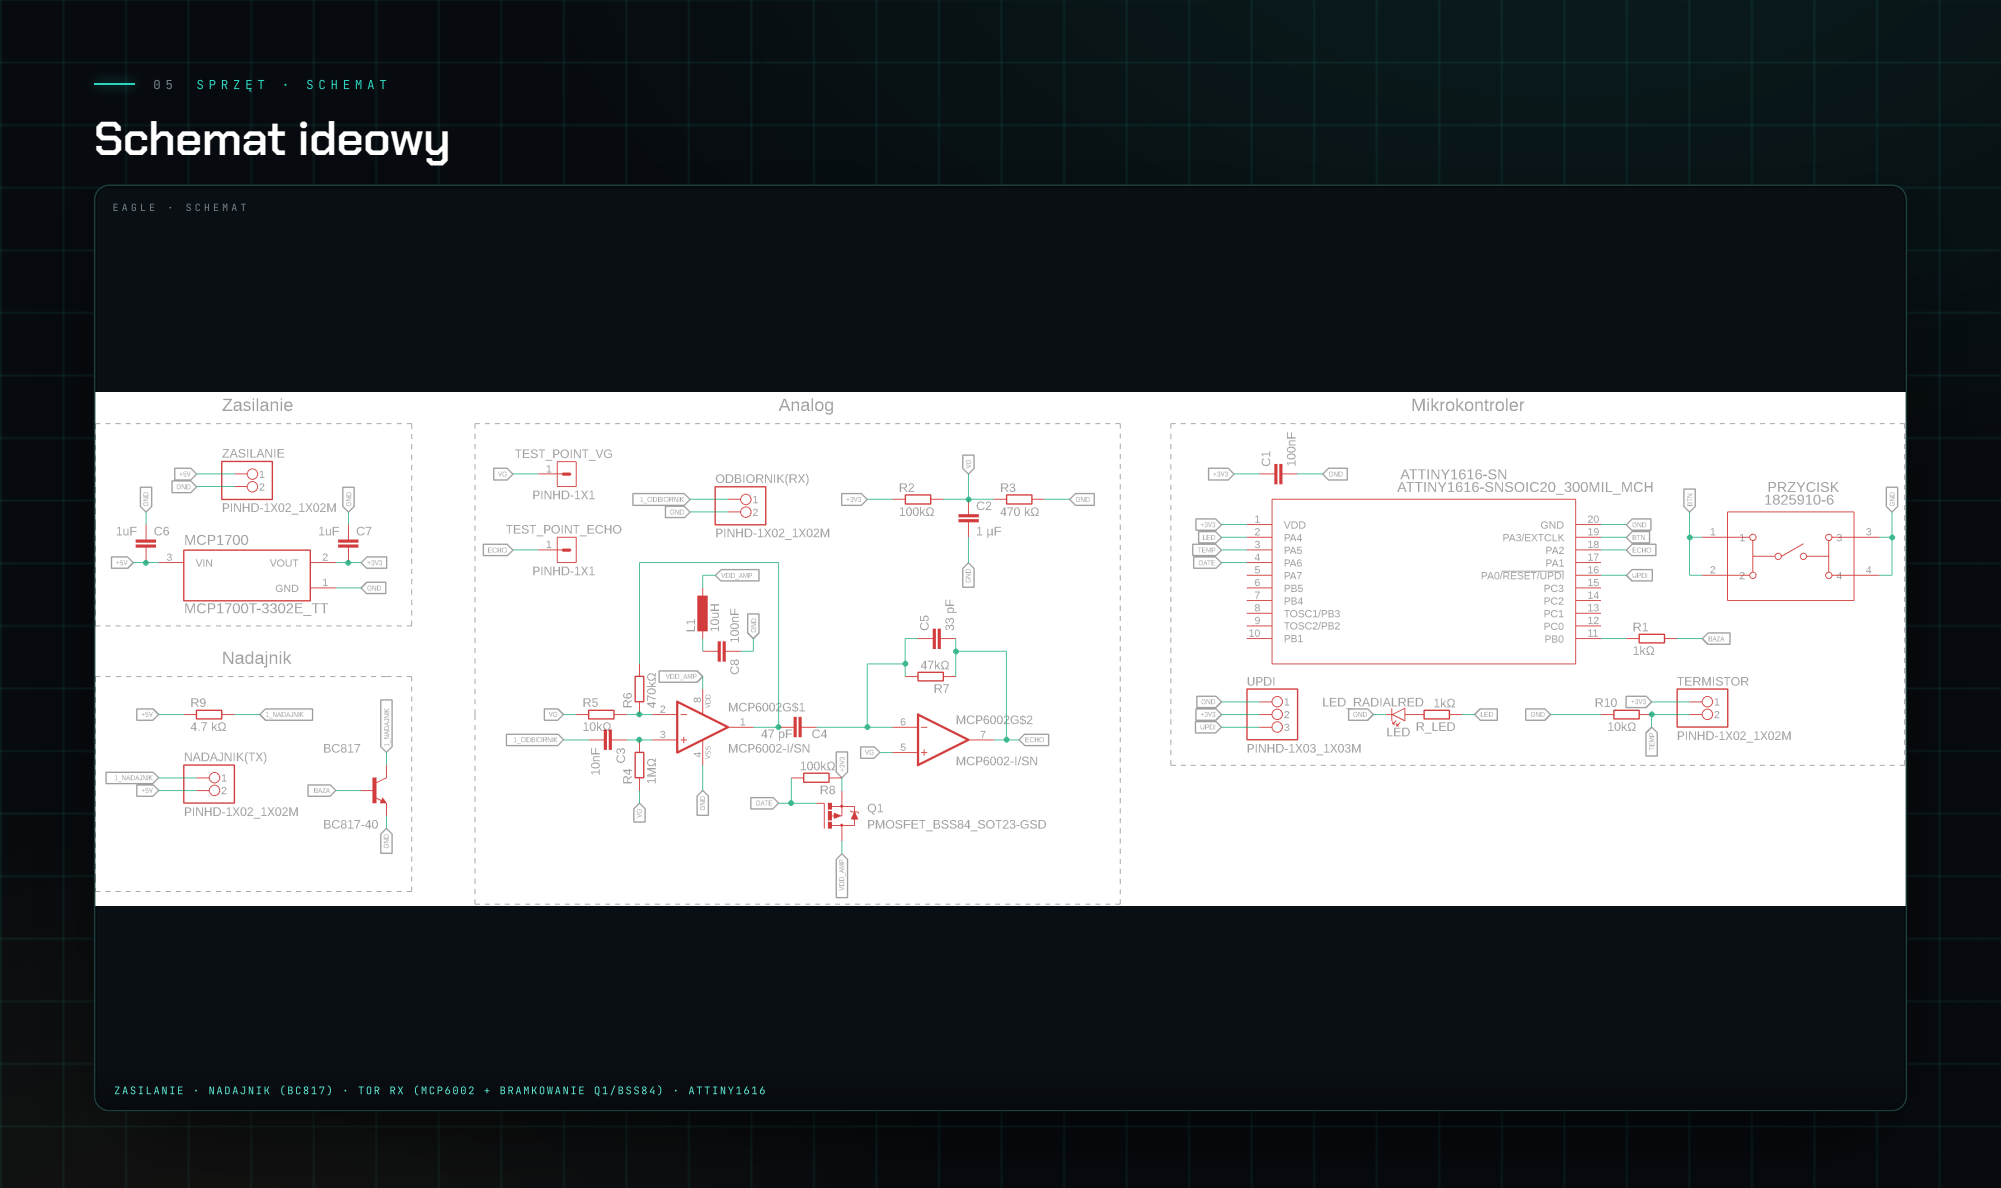
[picture p34: page 6]
ZASILANIE; NADAJNIK; TOR; (MCP6002; BRAMKOWANIE; Q1/BSS84) ·; ATTINY1616

# Płytka dwuwarstwowa 41 × 54,25 mm

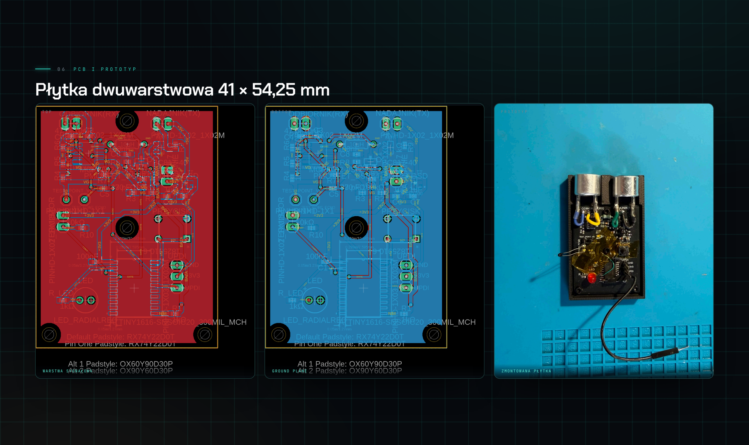
[picture p35: page 7]
WARSTWA; SYGNAŁOWA; GROUND; PLANE; ZMONTOWANA; PŁYTKA

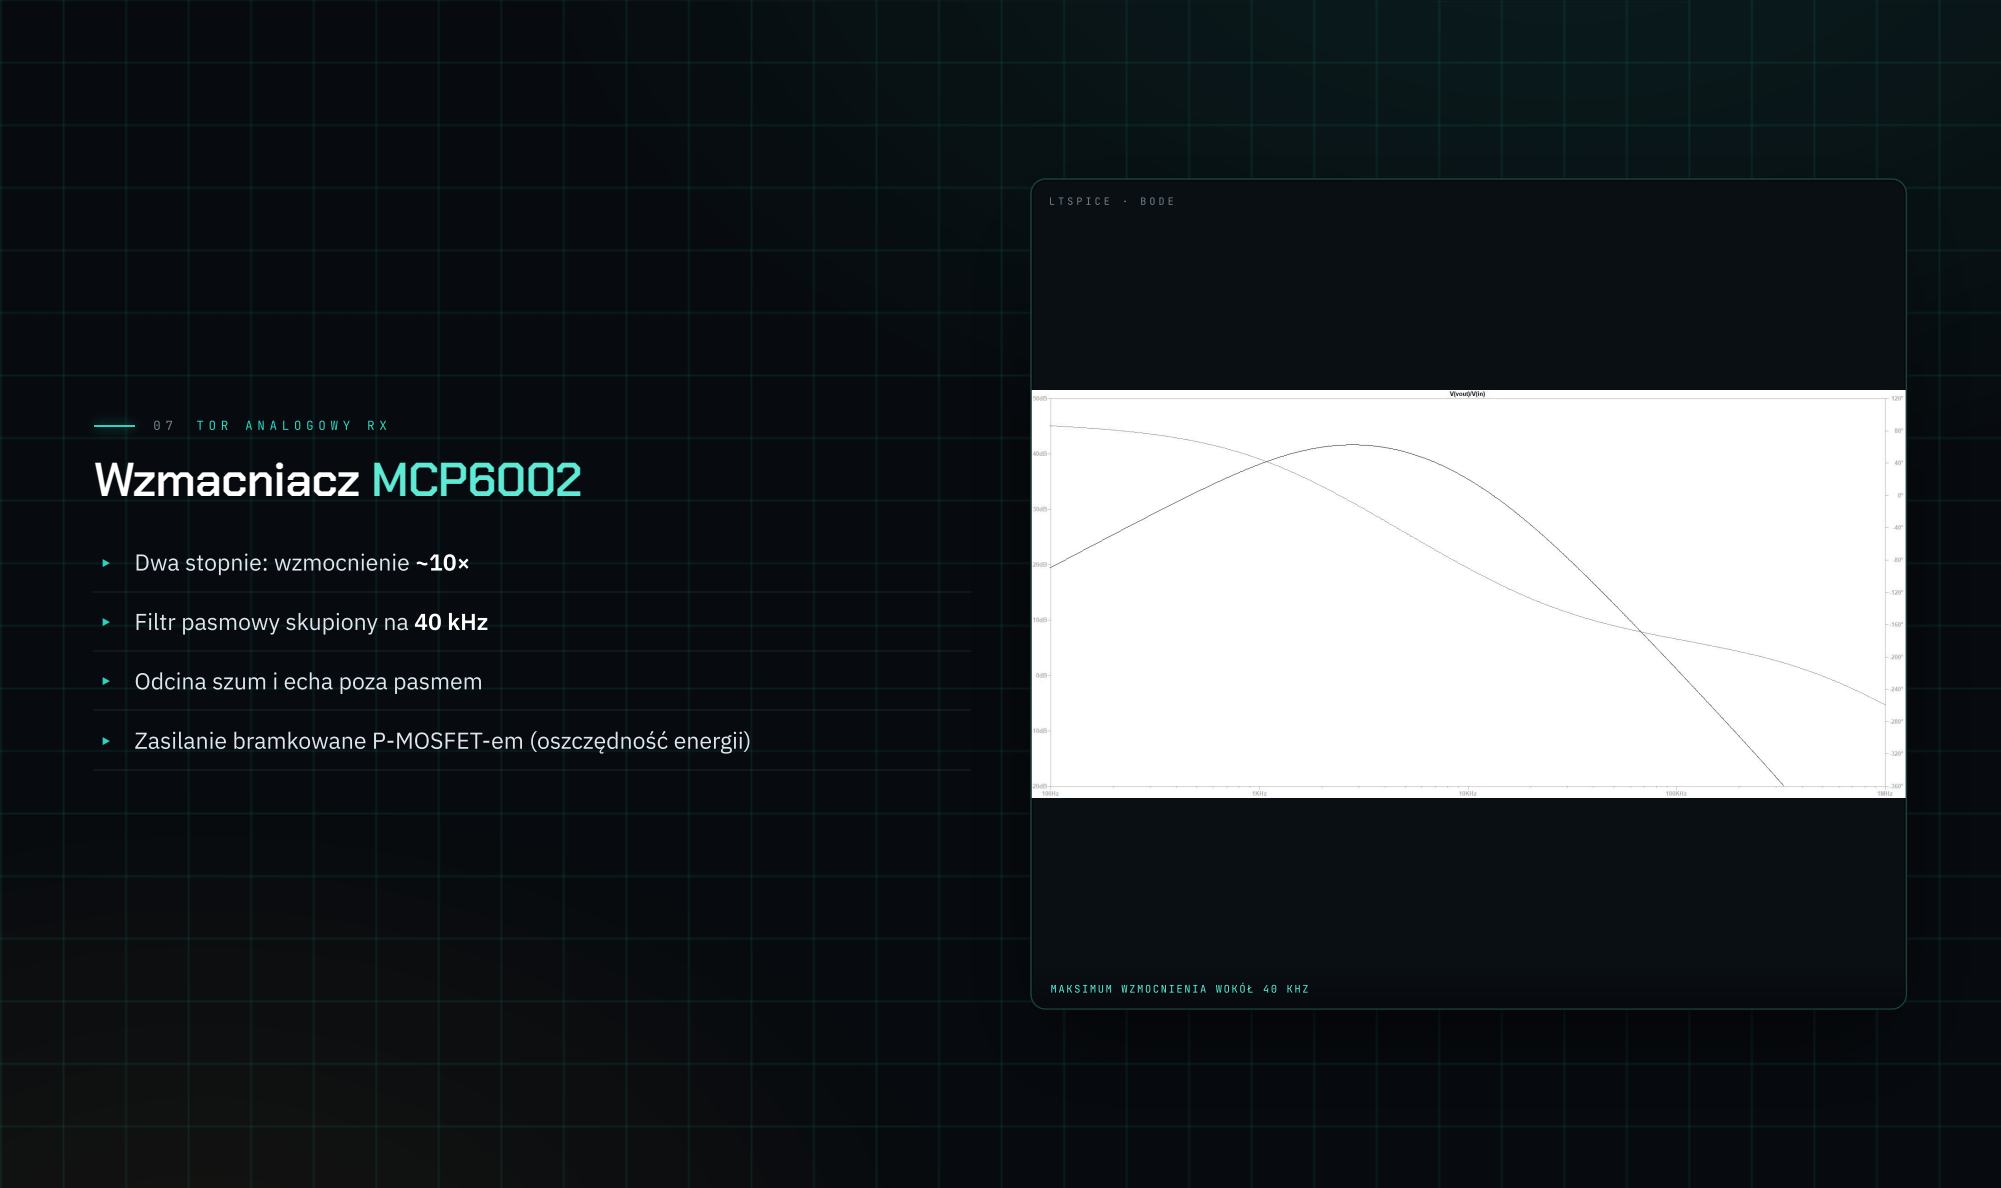
[picture p36: page 8]
Wzmacniacz MCP6002; MAKSIMUM; WZMOCNIENIA; WOKÓŁ 40 KHZ

▸ Dwa stopnie: wzmocnienie ~10×

▸ Filtr pasmowy skupiony na 40 kHz

▸ Odcina szum i echa poza pasmem

▸ Zasilanie bramkowane P-MOSFET-em (oszczędność energii)

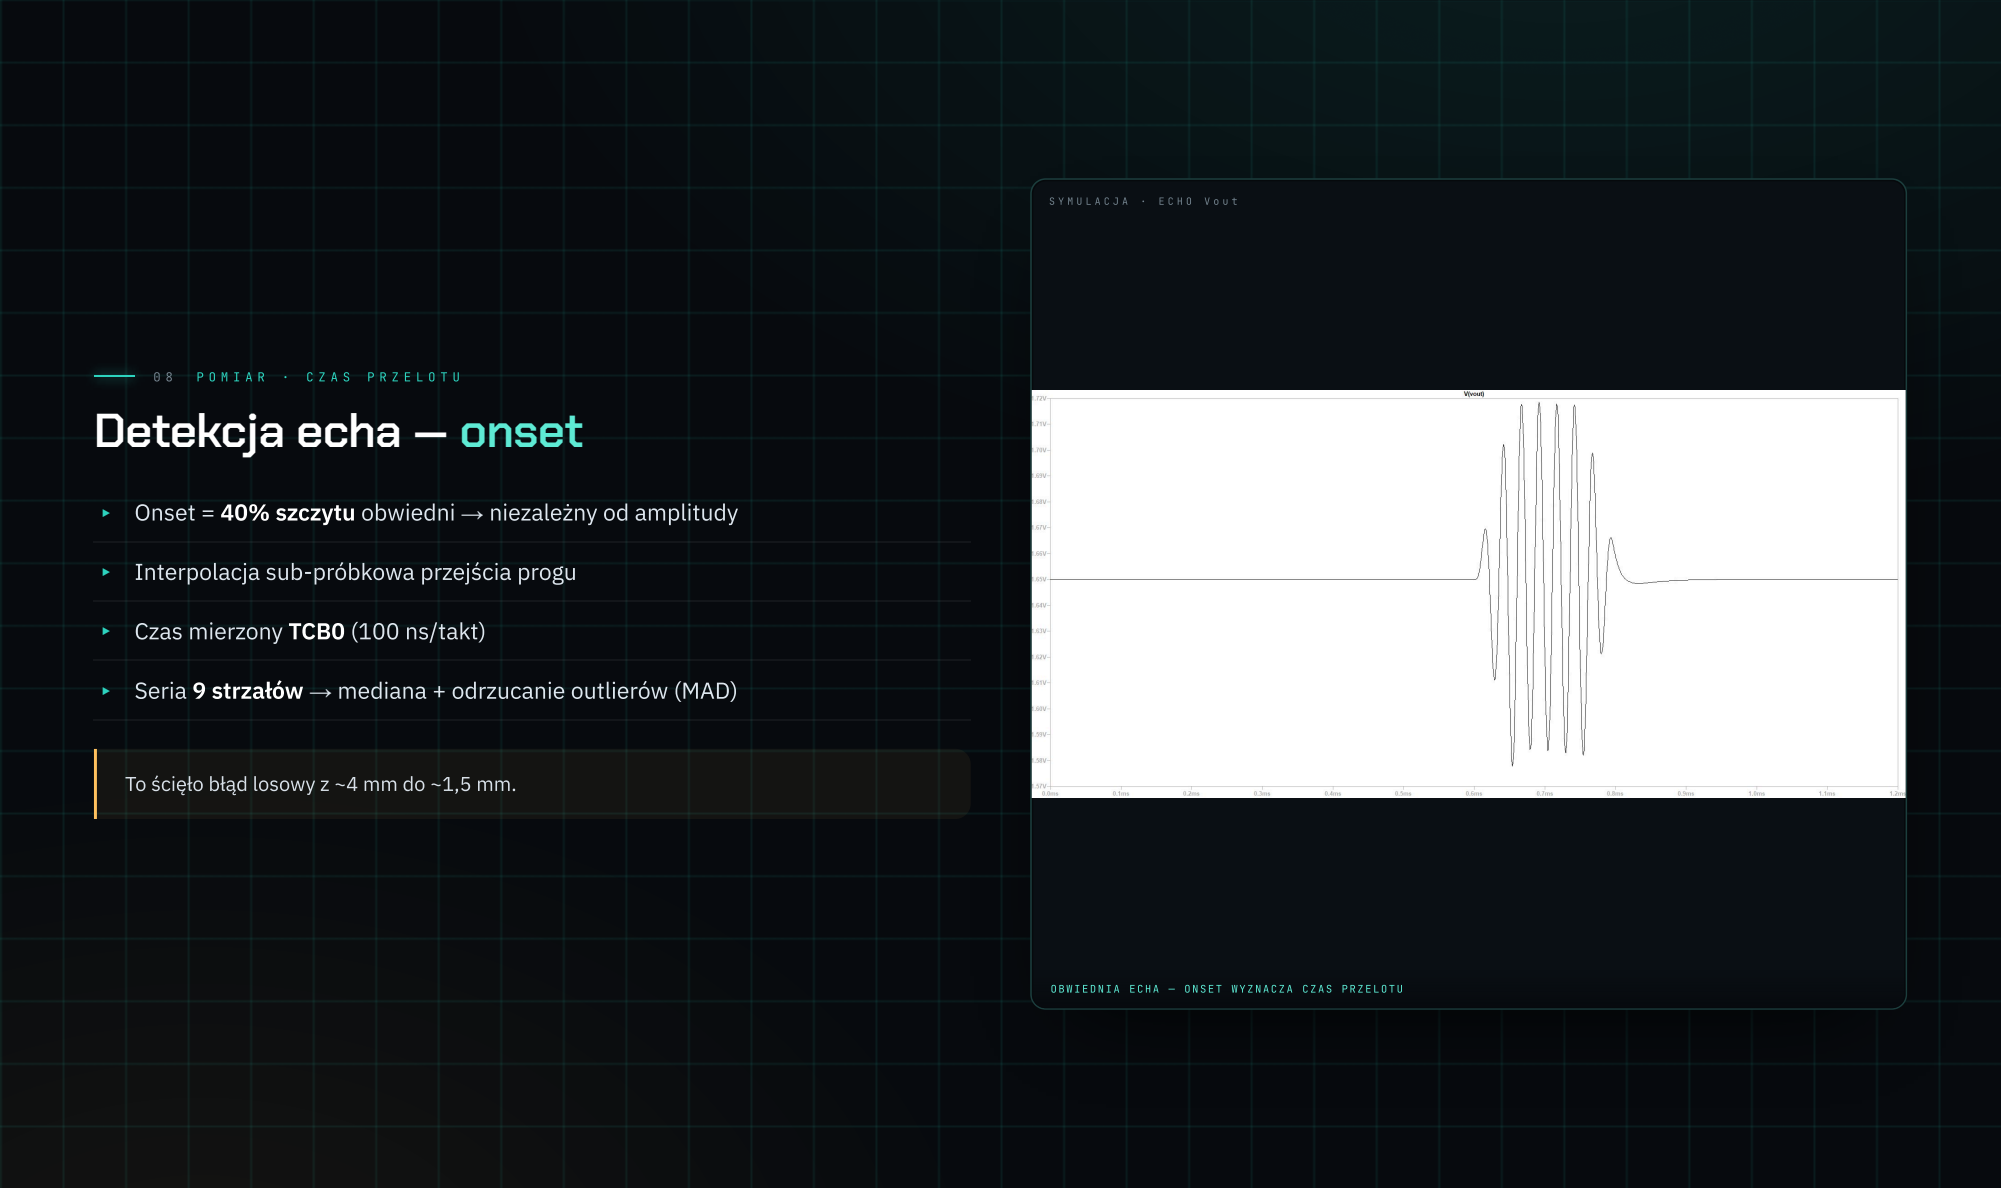
[picture p37: page 9]
OBWIEDNIA; ECHA; ONSET; WYZNACZA; CZAS PRZELOTU

Detekcja echa — onset

▸ Onset = 40% szczytu obwiedni → niezależny od amplitudy

▸ Interpolacja sub-próbkowa przejścia progu

▸ Czas mierzony TCB0 (100 ns/takt)

▸ Seria 9 strzałów → mediana + odrzucanie outlierów (MAD)

To ścięło błąd losowy z ~4 mm do ~1,5 mm.

0 9 | P O M I A R | · | F A Z A

# Filtr Goertzela — docinanie fazą

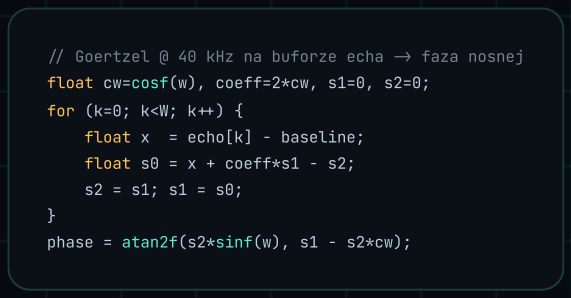
[picture p38: figure]
float cw=cosf(w), coeff=2*cw, s1=0, s2=0;; for (k=0; k<W; k +) {; float x; = echo[k] - baseline;; float s0 = x + coeff*s1 - s2;; phase = atan2f(s2*sinf(w), s1 - s2*cw);

/ Goertzel @ 40 kHz na buforze echa > faza nosnej
83°/mm

FAZA ZMIENIA SIĘ LINIOWO Z ODLEGŁOŚCIĄ

▸ Liczę jeden prążek DFT (taniej niż całe FFT — znam częstotliwość)

▸ Faza docina wynik do siatki λ/2 ≈ 4,3 mm; numer prążka z ToF

▸ Uśredniana po pingach + miara spójności PLV

1 0 | Z A R Z Ą D Z A N I E | M O C Ą

# Spoczynek 0,9 mW

STAN | PRĄD @ 5V | MOC
Spoczynek | 0,18 mA | 0,9 mW
Pomiar (~70 ms) | 2–4,5 mA | 10–22 mW

0,9 mW

→ MAKSYMALNE 50 pkt za moc

▸ Tryb Standby + budzenie z RTC co 125 ms

▸ Wzmacniacz odcinany P-MOSFET-em (Q1) → 0 µA w spoczynku

▸ ADC i peryferia włączane tylko na czas pomiaru

# Zmierzony błąd RMSE ≈ 2,4 mm

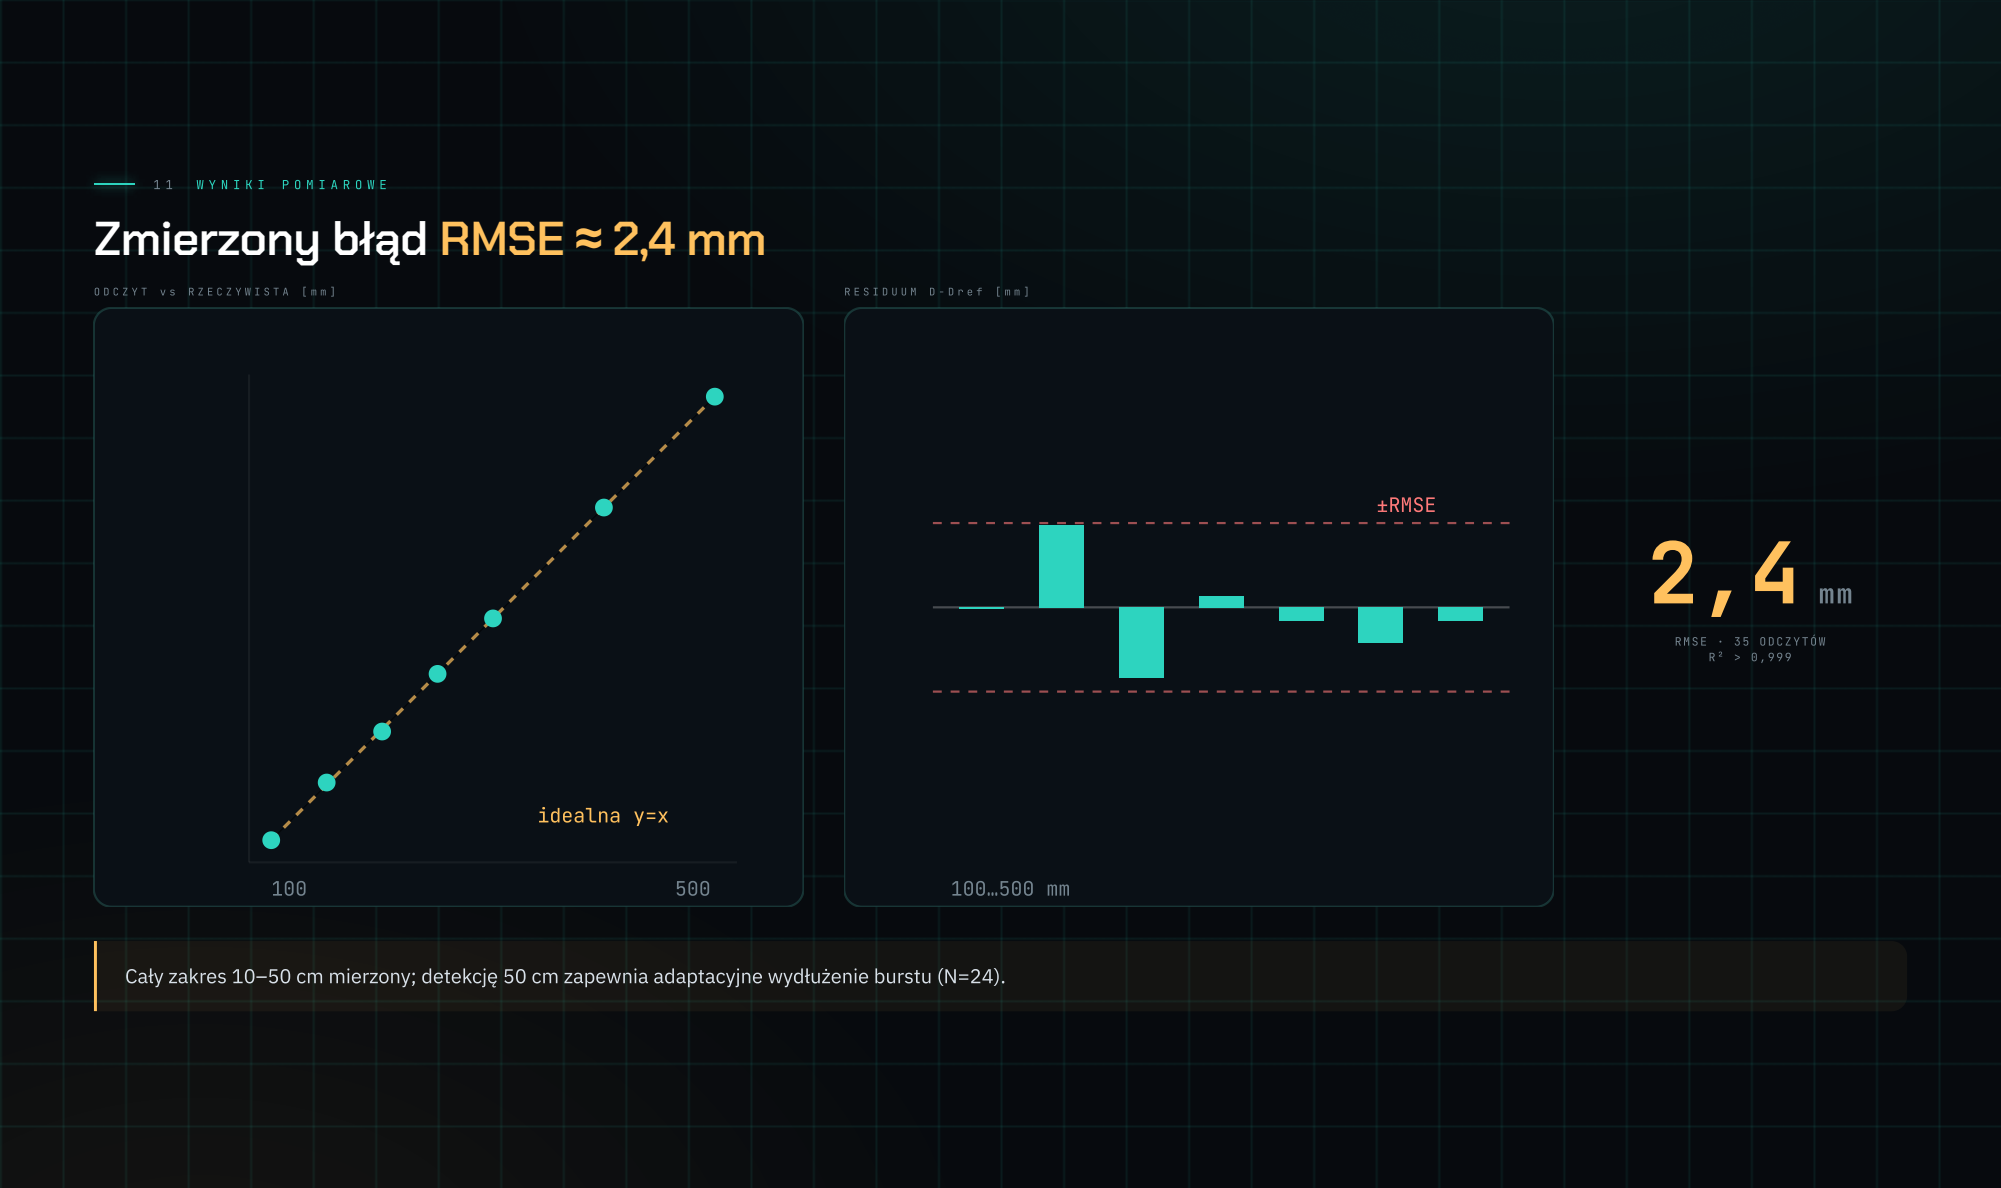
[picture p39: page 12]
idealna y=x; ±RMSE; RMSE · 35 ODCZYTÓW

Cały zakres 10–50 cm mierzony; detekcję 50 cm zapewnia adaptacyjne wydłużenie burstu (N=24).

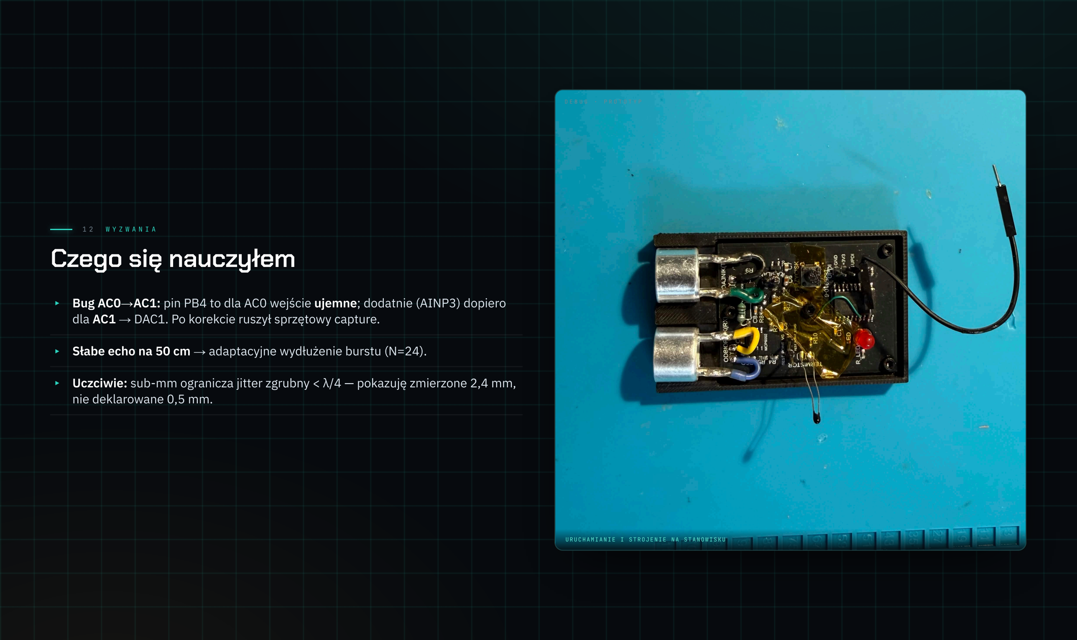
[picture p40: page 13]

1 2 W Y Z W A N I A

# Czego się nauczyłem

Bug AC0→AC1: pin PB4 to dla AC0 wejście ujemne; dodatnie (AINP3) dopiero dla AC1 → DAC1. Po korekcie ruszył sprzętowy capture.

▸

▸ Słabe echo na 50 cm → adaptacyjne wydłużenie burstu (N=24).

Uczciwie: sub-mm ogranicza jitter zgrubny < λ/4 — pokazuję zmierzone 2,4 mm, nie deklarowane 0,5 mm.

▸

D E B U G | · | P R O T O T Y P
URUCHAMIANIE | I | STROJENIE | NA | STANOWISKU

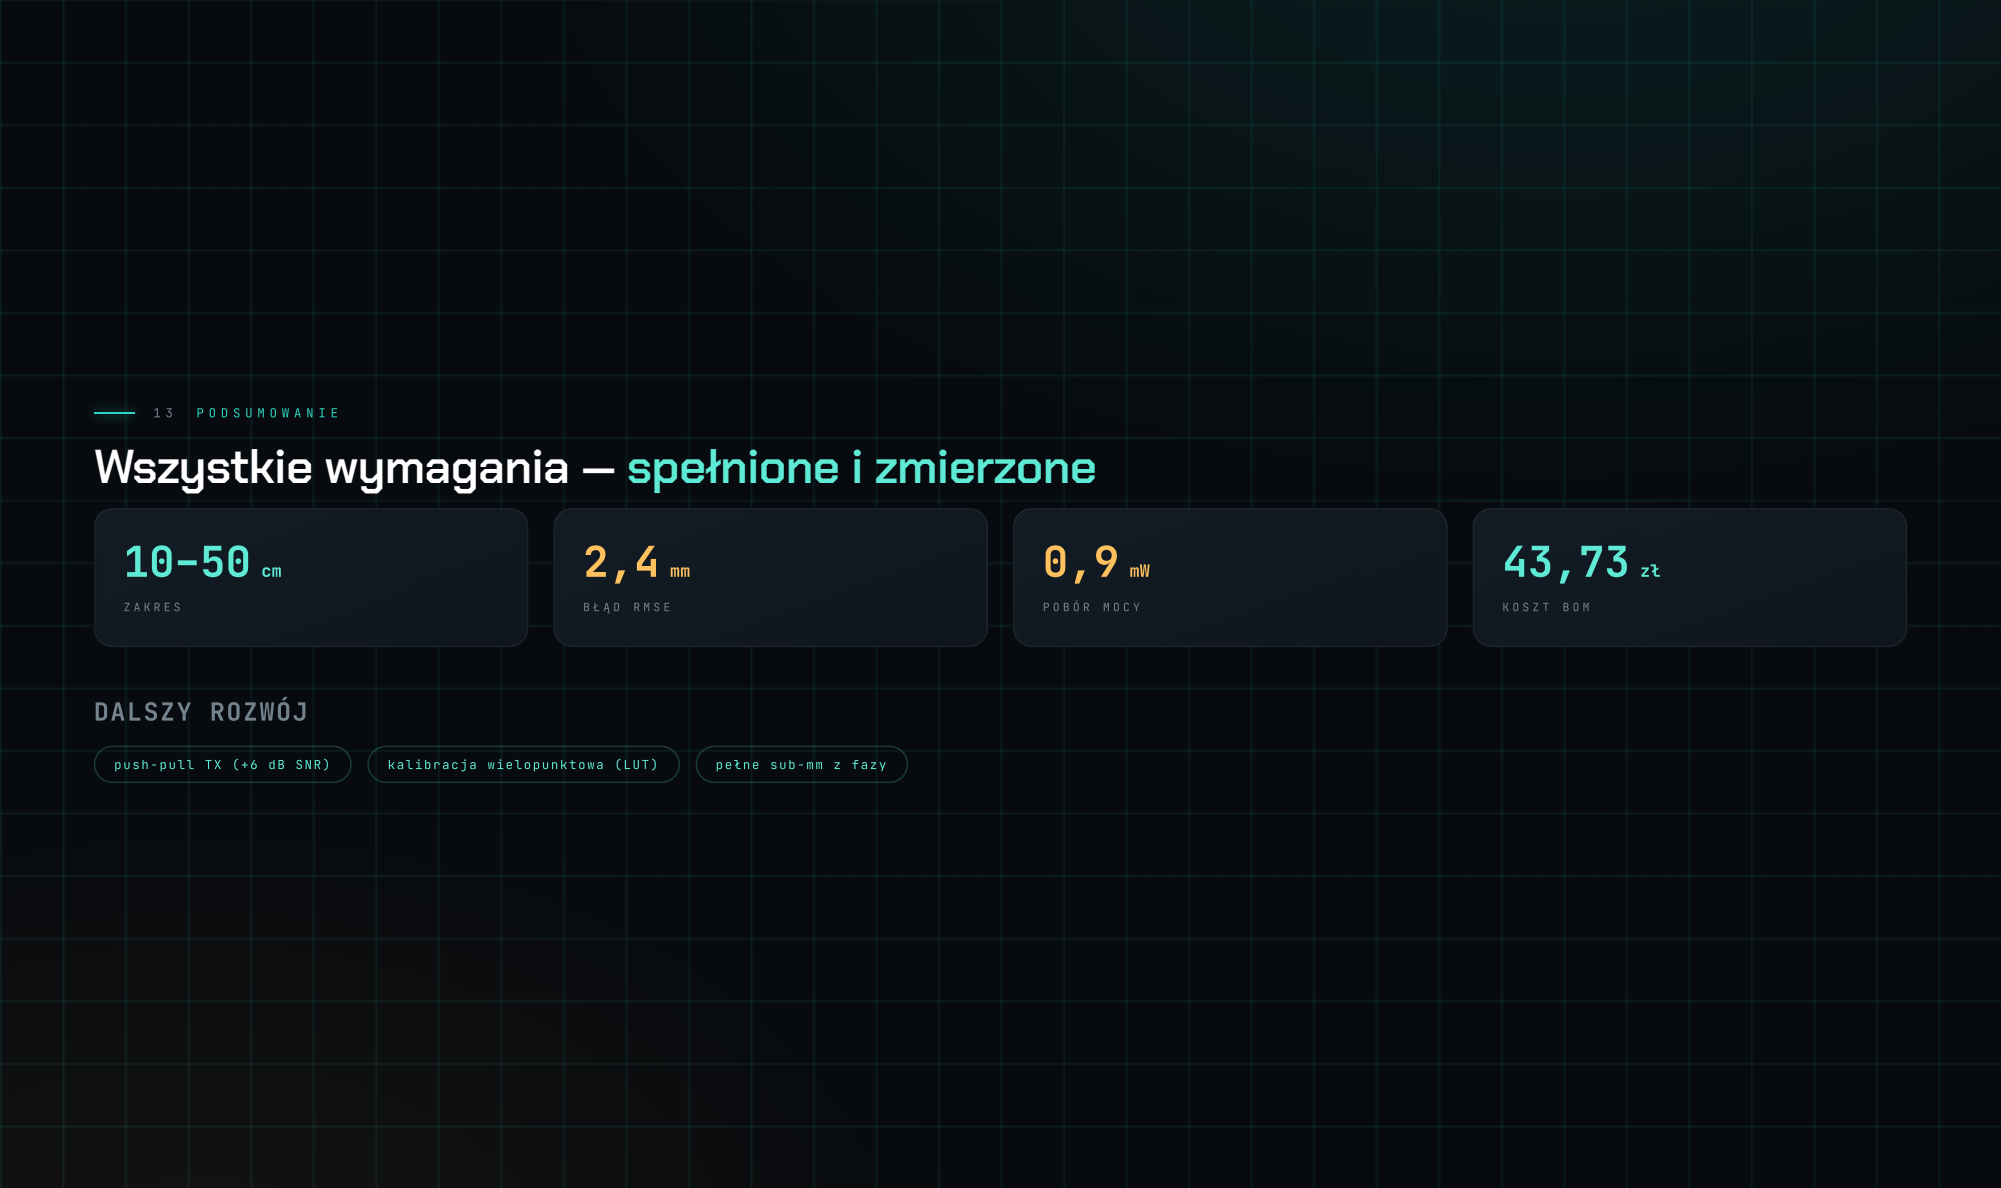
[picture p41: page 14]
DALSZY ROZWÓJ; push-pull TX (+6 dB SNR); kalibracja wielopunktowa (LUT); pełne sub-mm z fazy

Wszystkie wymagania — spełnione i zmierzone

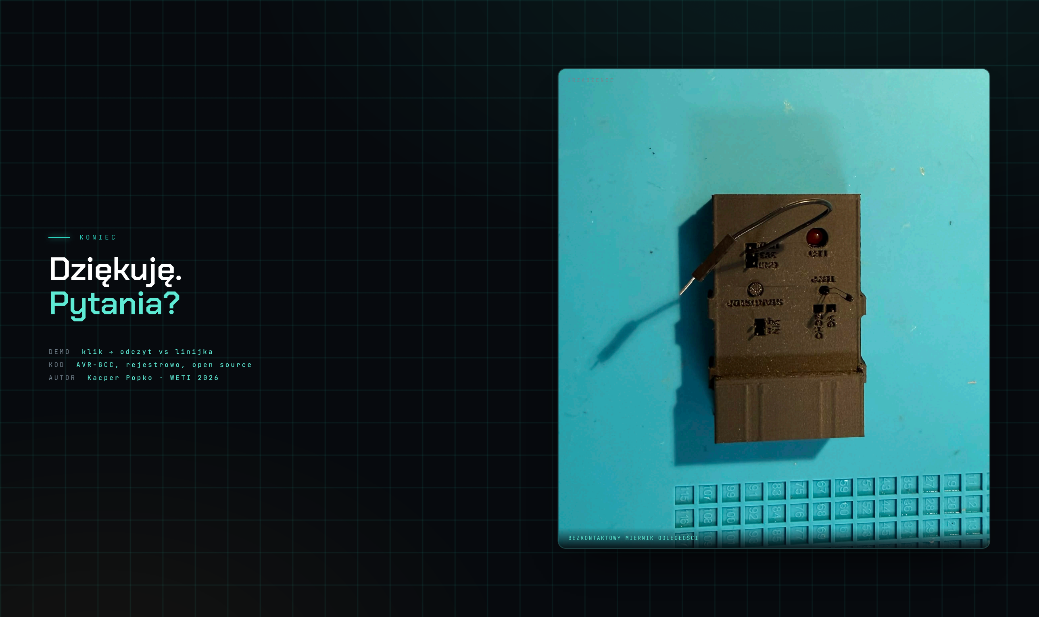
[picture p42: page 15]

K O N I E C
Dziękuję.

# Pytania?

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

U R Z Ą D Z E N I E

BEZKONTAKTOWY | MIERNIK | ODLEGŁOŚCI
