KAJPER/WETI/deliverables/cad/bezkontaktowy miernik odległości.brd

## EAGLE design deliverables/cad/bezkontaktowy miernik odległości.brd (2026-06-11)

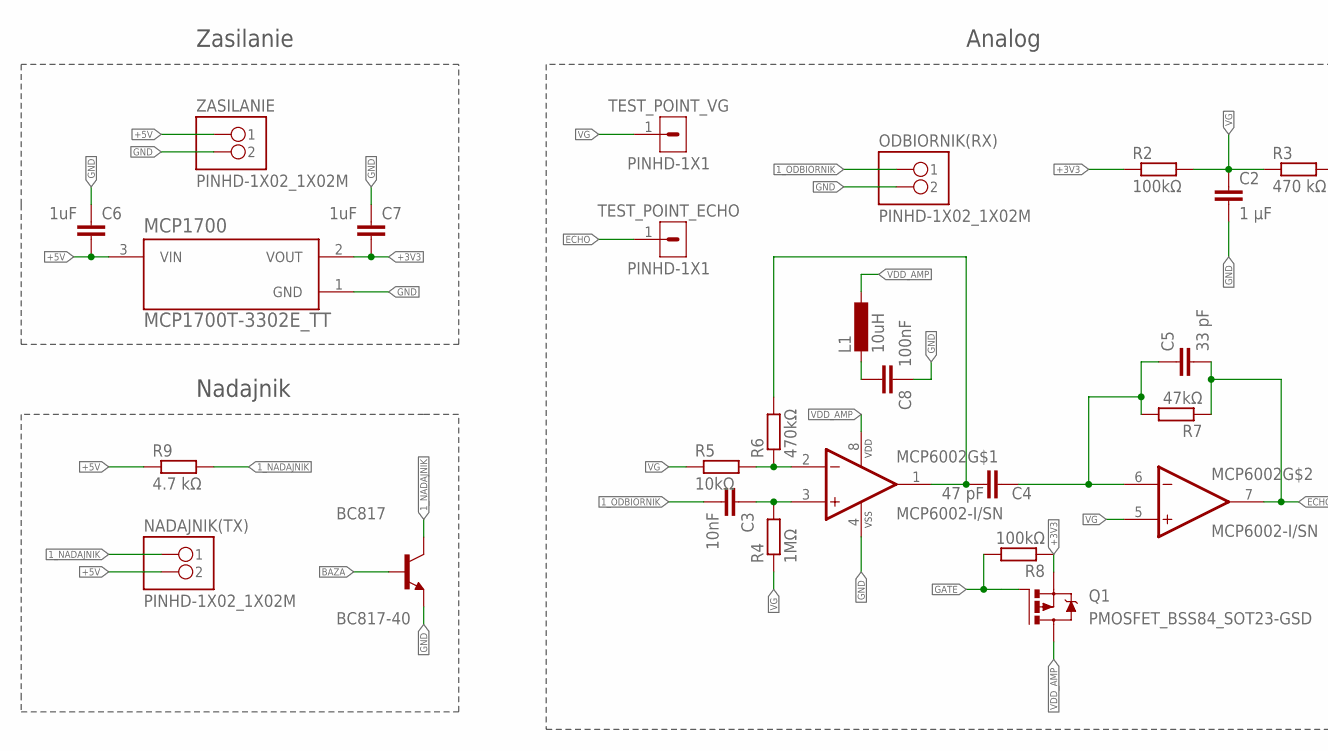
[picture p43: schematic bezkontaktowy_miernik_odległości.sch, part in row 1, column 1]

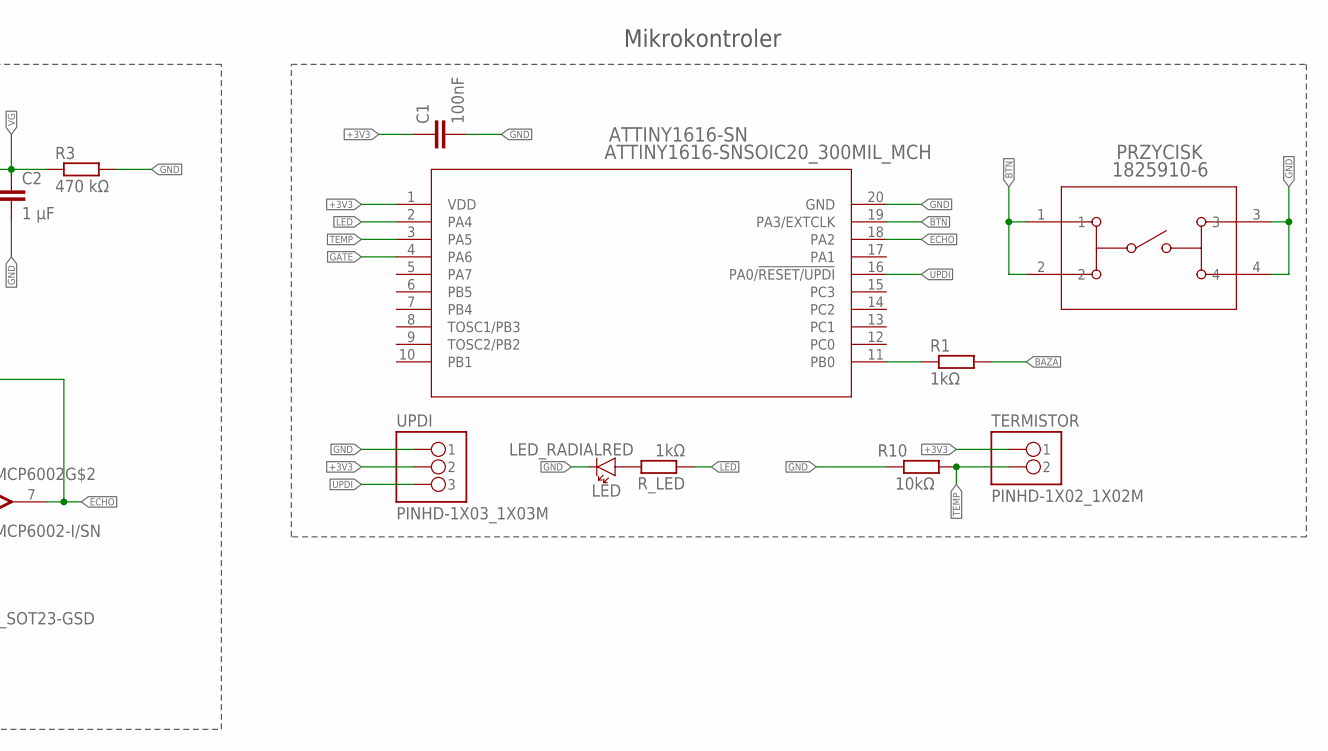
[picture p44: schematic bezkontaktowy_miernik_odległości.sch, part in row 1, column 2]

Parts:
ATTINY1616-SN: ATTINY1616-SNSOIC20_300MIL_MCH; SOIC20_300MIL_MCH
BC817: BC817-40; SOT95P240X120-3N
C1, C8: 100nF; C0603
C2: 1 µF; C0603
C3: 10nF; C0603
C4: 47 pF; C0603
C5: 33 pF; C0603
C6, C7: 1uF; C0603
L1: 10uH; 0204/7
LED: LED_RADIALRED; LEDRD254W60D565H860B_R
MCP1700: MCP1700T-3302E_TT; SOT95P237X112-3N
MCP6002: MCP6002-I/SN; SOIC127P600X175-8N
NADAJNIK(TX): PINHD-1X02_1X02M; 1X02
ODBIORNIK(RX): PINHD-1X02_1X02M; 1X02
PRZYCISK: 1825910-6; SW4_1825910-B
Q1: PMOSFET_BSS84_SOT23-GSD; SOT23
R1: 1kΩ; R0603
R2, R8: 100kΩ; R0603
R3: 470 kΩ; R0603
R4: 1MΩ; R0603
R5, R10: 10kΩ; R0603
R6: 470kΩ; R0603
R7: 47kΩ; R0603
R9: 4.7 kΩ; R0603
R_LED: 1kΩ; R0603
TERMISTOR: PINHD-1X02_1X02M; 1X02
TEST_POINT_ECHO: PINHD-1X1; 1X01
TEST_POINT_VG: PINHD-1X1; 1X01
UPDI: PINHD-1X03_1X03M; 1X03
ZASILANIE: PINHD-1X02_1X02M; 1X02

Connections:
1_NADAJNIK: BC817.3 (C), NADAJNIK(TX).1, R9.2
1_ODBIORNIK: C3.2, ODBIORNIK(RX).1
+3V3: ATTINY1616-SN.1 (VDD), C1.1, C7.2, MCP1700.2 (VOUT), Q1.2 (S), R2.1, R8.1, TERMISTOR.1, UPDI.2
+5V: C6.2, MCP1700.3 (VIN), NADAJNIK(TX).2, R9.1, ZASILANIE.1
BAZA: BC817.1 (B), R1.2
BTN: ATTINY1616-SN.19 (PA3/EXTCLK), PRZYCISK.1, PRZYCISK.2
ECHO: ATTINY1616-SN.18 (PA2), C5.2, MCP6002.7 (VOUTB), R7.1, TEST_POINT_ECHO.1
GATE: ATTINY1616-SN.4 (PA6), Q1.1 (G), R8.2
GND: ATTINY1616-SN.20 (GND), BC817.2 (E), C1.2, C2.2, C6.1, C7.1, C8.1, LED.C, MCP1700.1 (GND), MCP6002.4 (VSS), ODBIORNIK(RX).2, PRZYCISK.3, PRZYCISK.4, R3.2, R10.1, UPDI.1, ZASILANIE.2
LED: ATTINY1616-SN.2 (PA4), R_LED.1
unnamed: C3.1, MCP6002.3 (VINA+), R4.2
unnamed: MCP6002.2 (VINA-), R5.2, R6.1
unnamed: C4.2, MCP6002.1 (VOUTA), R6.2
unnamed: LED.A, R_LED.2
unnamed: C4.1, C5.1, MCP6002.6 (VINB-), R7.2
unnamed: C8.2, L1.2
unnamed: ATTINY1616-SN.11 (PB0), R1.1
TEMP: ATTINY1616-SN.3 (PA5), R10.2, TERMISTOR.2
UPDI: ATTINY1616-SN.16 (PA0/!RESET/UPDI), UPDI.3
VDD_AMP: L1.1, MCP6002.8 (VDD), Q1.3 (D)
VG: C2.1, MCP6002.5 (VINB+), R2.2, R3.1, R4.1, R5.1, TEST_POINT_VG.1

Notes on the sheet:
Zasilanie
Nadajnik
Analog
Mikrokontroler

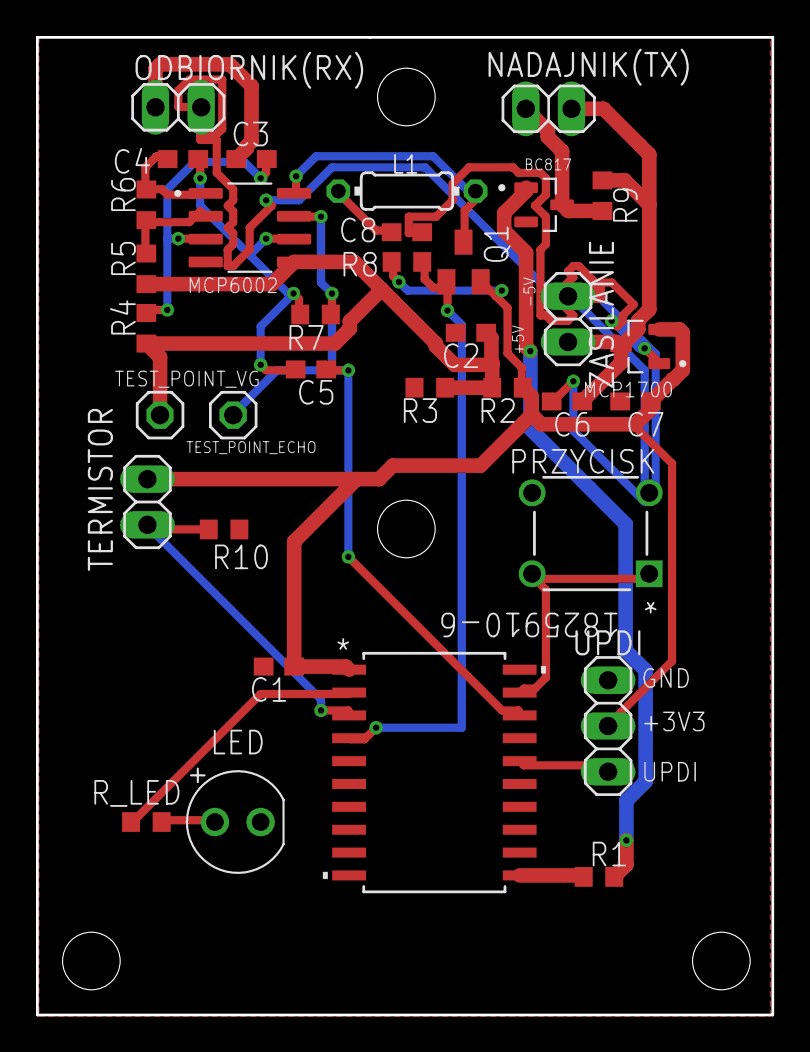
[picture p45: board bezkontaktowy miernik odległości.brd from above]

Board: 2 copper layers, 40.9 x 54.3 mm, 34 parts (0 on the bottom side), 21 nets.
