KAJPER/WETI/(commit log)

2026-06-09 Add initial documentation for stage 1 in PDF format
2026-06-11 Add ESP32 power monitor and I2C scanner sketches
    - Implemented a power monitor for the WETI ultrasonic distance meter using INA219, featuring a web dashboard for live current, voltage, and power readings.
    - Added an I2C scanner sketch to identify connected I2C devices and their addresses.
2026-06-11 Add documentation for Stage 2 of the ultrasonic distance meter project
    - Created a new LaTeX document for Stage 2 documentation detailing the prototype's design, architecture, and performance.
    - Included sections on the introduction, requirements fulfillment, device architecture, firmware details, power management, measurement results, changes from Stage 1, deliverables, and future development.
    - Added a table of contents for easy navigation within the document.
    [bezkontaktowy miernik odległości.brd, bezkontaktowy_miernik_odległości.sch]
2026-06-13 Add measurement characteristics and residual analysis plots to documentation
    - Included a new figure displaying the measurement characteristics after calibration, showing the correlation between actual distance and readings with a high R² value.
    - Added a second figure illustrating the residuals of the measurements compared to the reference, including error margins.
    - Updated LaTeX document to incorporate the new plots using the pgfplots package for enhanced visualization.
    Update firmware map file with new temporary object file references
    - Replaced references to temporary object files in the firmware map with updated file names.
    - Ensured consistency in the linker script and memory map b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
2026-06-23 Add presentation notes for WETI 2026 on ultrasonic distance measurement project
