KAJPER/WETI/(notices)

Notices in the files:
parts and their libraries:
COPYRIGHT: Copyright (C) 2025 Ultra Librarian. All rights reserved.
COPYRIGHT: Copyright (C) 2016 Accelerated Designs. All rights reserved
